Hui404/CoreScribe/CAD/Assemblies/装配.SLDASM

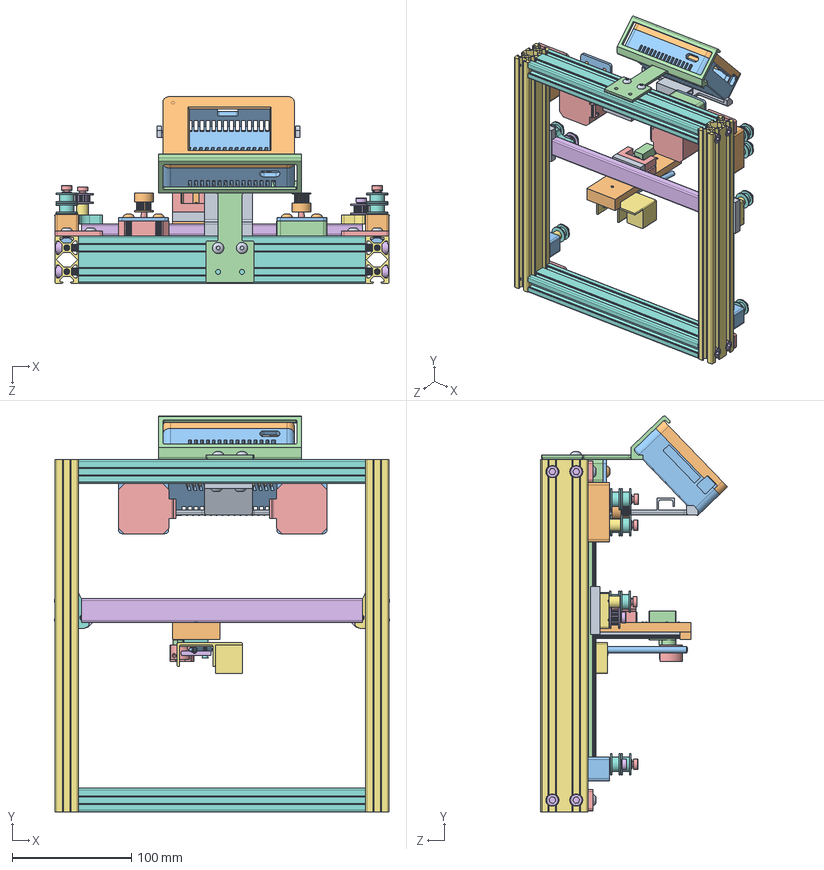
[picture p3: CAD file, 2026-03-18]
CAD/Assemblies/装配.SLDASM
280.8 x 331.6 x 156.7 mm
铝型材2040_X轴_260mm x 2
铝型材2040_Y轴_295mm x 2
内六角平圆头螺钉M6x20 x 8
一字连接片2020型2孔 x 4
线轨180mm x 2
定柱_前 x 2
定柱_后 x 2
MGN9H滑块 x 3
连接件_右
连接件_左
铝型材1020
步进电机 x 2
电机增高柱2
电机安装支架 x 2
同步轮20齿内孔5带宽6 x 2
垫片M5x8x0.5 x 22
惰轮_20齿内孔5带宽6不带齿 x 10
隔离柱 x 4
惰轮_20齿内孔5带宽6带齿 x 2
固定连接
内六角平圆头螺钉M3x8
滑块螺母20型材M5 x 22
内六角平圆头螺钉M5x20 x 4
内六角平圆头螺钉M5x8 x 16
平头内六角螺钉M3x10 x 9
平头内六角螺钉M5x12 x 2
内六角台阶螺钉5xM4x10 x 4
内六角台阶螺钉5xM4x20 x 6
SG90
笔芯
连接件2.1
线轨50mm
MGN9C滑块
连接件2.2
连接件2.3
连接件_棉线
支架1
外壳1
外壳2
支架2
