Hui404/CoreScribe/CAD/3D打印文件/显示器支架1.STL

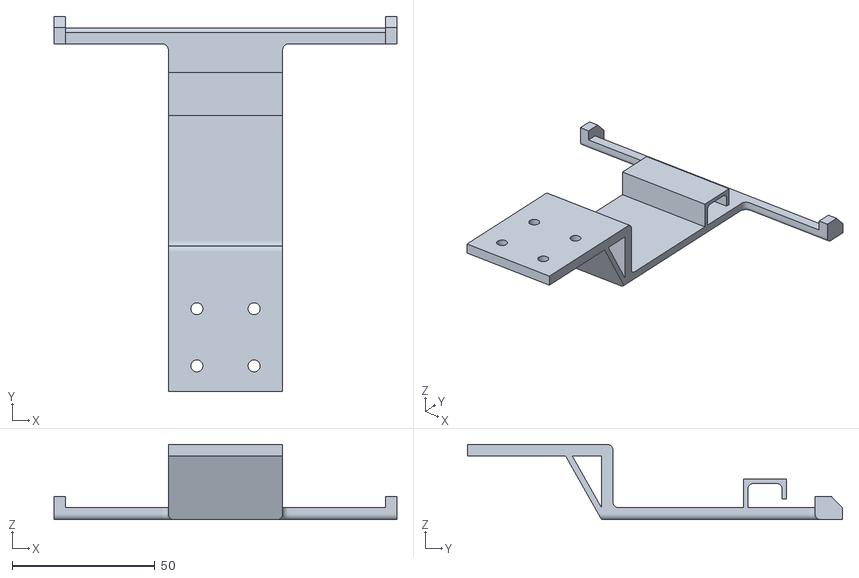
[picture p4: CAD file, 2026-03-18]
CAD/3D打印文件/显示器支架1.STL
120.0 x 131.3 x 26.3
