Hui404/CoreScribe/CAD/parts/内六角台阶螺钉5xM4x20.SLDPRT

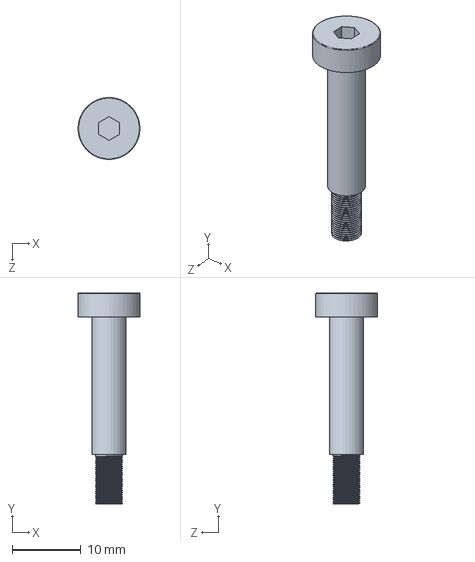
[picture p5: CAD file, 2026-03-18]
CAD/parts/内六角台阶螺钉5xM4x20.SLDPRT
9.00 x 30.7 x 9.00 mm
