Hui404/CoreScribe/CAD/3D打印文件/舵机连接件3.STL

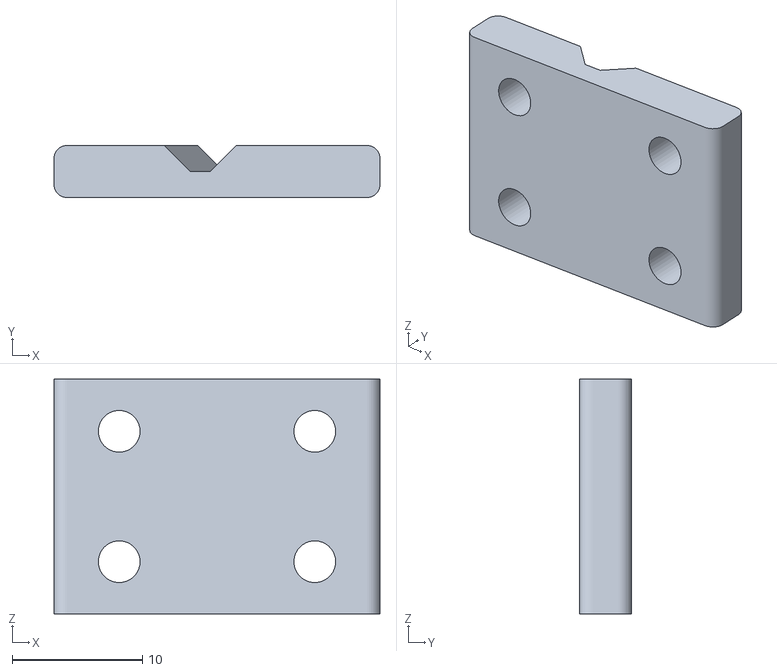
[picture p6: CAD file, 2026-03-18]
CAD/3D打印文件/舵机连接件3.STL
25.0 x 4.00 x 18.0
