Hui404/CoreScribe/CAD/parts/电机增高柱2.SLDPRT

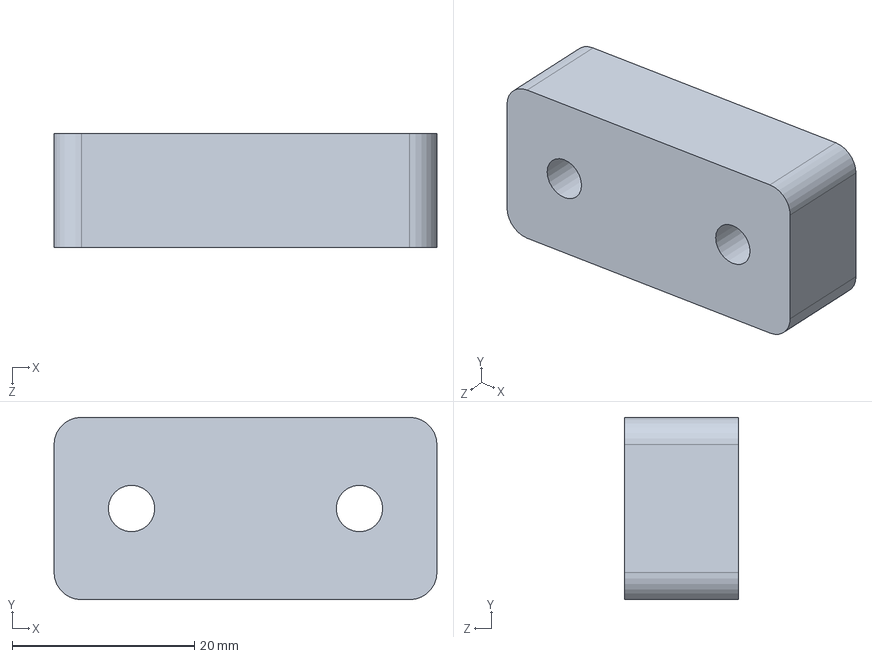
[picture p7: CAD file, 2026-03-18]
CAD/parts/电机增高柱2.SLDPRT
42.0 x 20.0 x 12.5 mm
