Hui404/CoreScribe/CAD/3D打印文件/舵机连接件1.STL

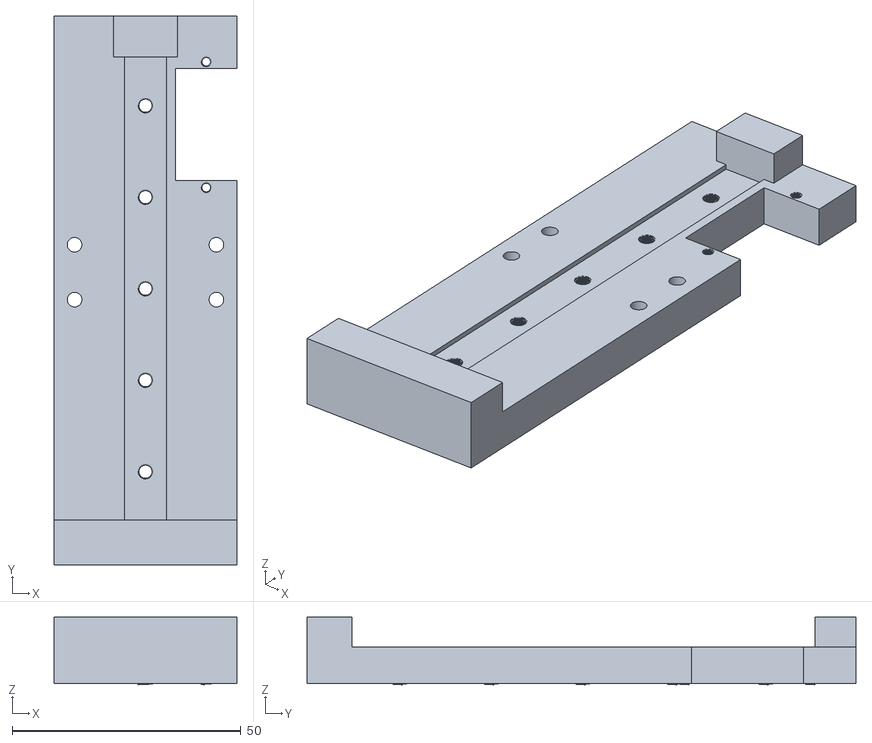
[picture p8: CAD file, 2026-03-18]
CAD/3D打印文件/舵机连接件1.STL
40.0 x 120.0 x 14.8
