Hui404/CoreScribe/CAD/parts/外壳2.SLDPRT

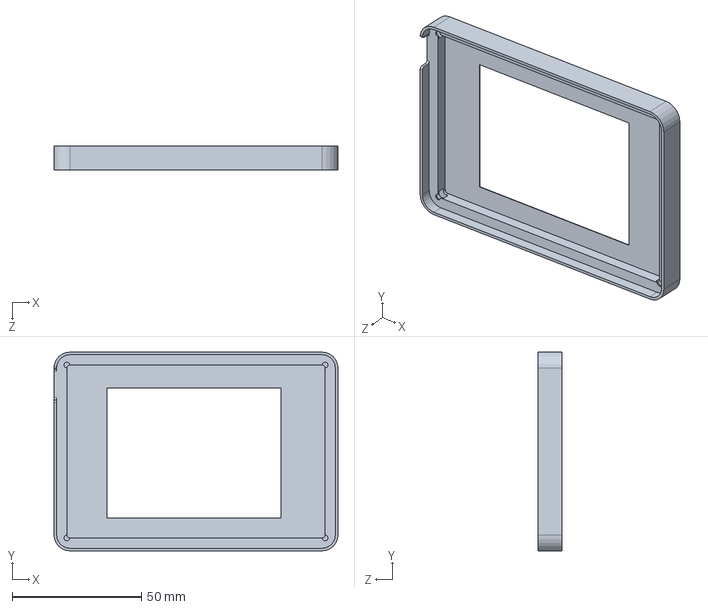
[picture p9: CAD file, 2026-03-18]
CAD/parts/外壳2.SLDPRT
110.0 x 77.0 x 9.30 mm
