Hui404/CoreScribe/CAD/3D打印文件/控制器外壳1.STL

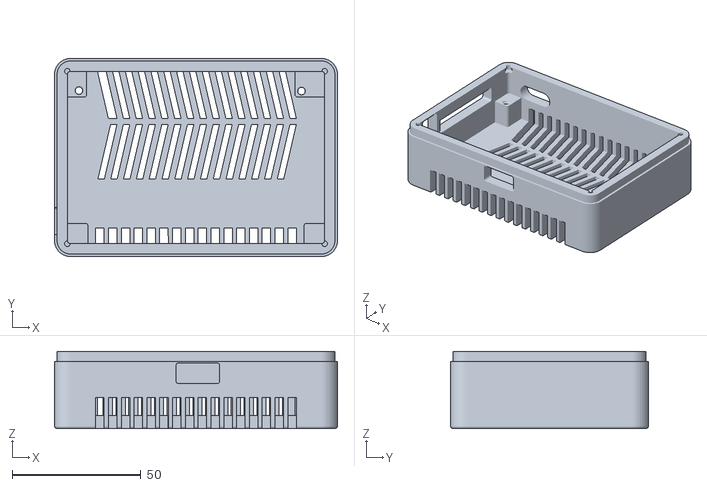
[picture p10: CAD file, 2026-03-18]
CAD/3D打印文件/控制器外壳1.STL
110.0 x 77.0 x 30.0
