Hui404/CoreScribe/CAD/parts/内六角台阶螺钉5xM4x10.SLDPRT

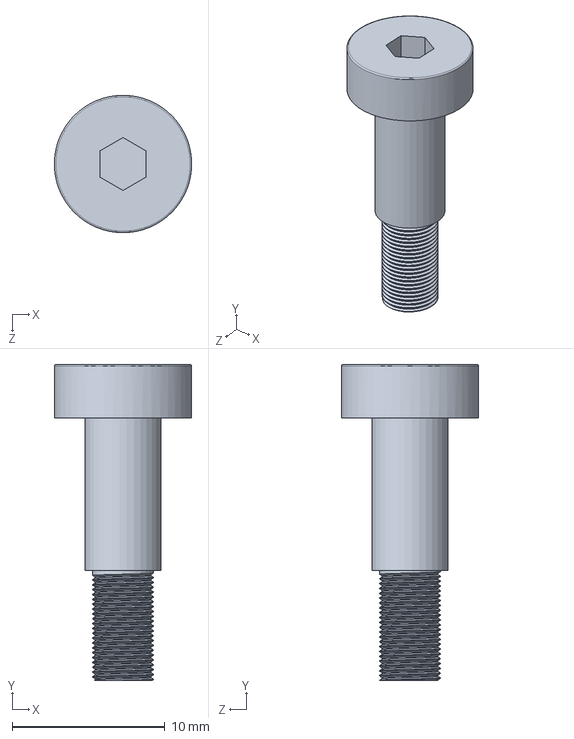
[picture p11: CAD file, 2026-03-18]
CAD/parts/内六角台阶螺钉5xM4x10.SLDPRT
9.00 x 20.7 x 9.00 mm
