Hui404/CoreScribe/CAD/parts/SG90.SLDPRT

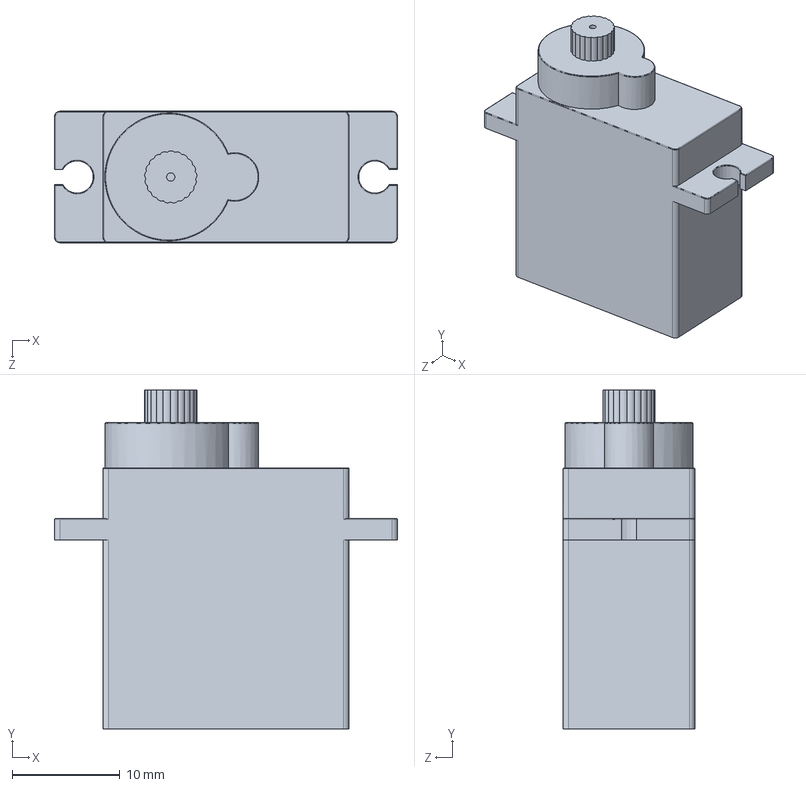
[picture p12: CAD file, 2026-03-18]
CAD/parts/SG90.SLDPRT
31.8 x 31.4 x 12.2 mm
