Hui404/CoreScribe/CAD/3D打印文件/连接件_右.STL

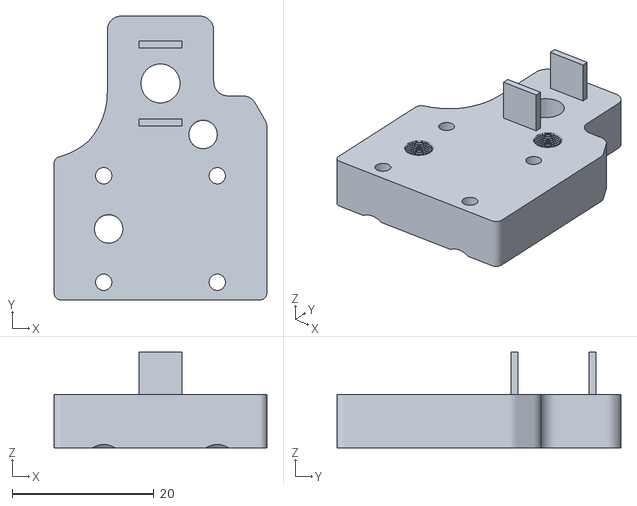
[picture p13: CAD file, 2026-03-18]
CAD/3D打印文件/连接件_右.STL
30.0 x 40.0 x 13.5
