Hui404/CoreScribe/CAD/parts/连接件_棉线.SLDPRT

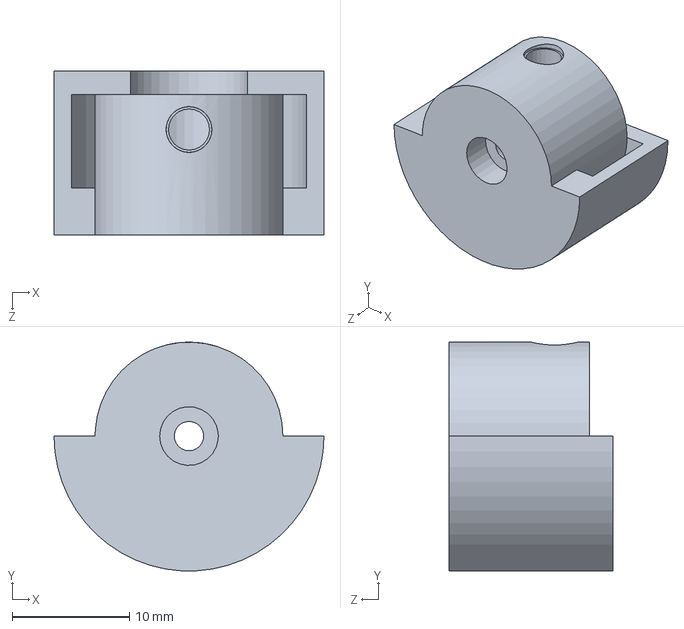
[picture p14: CAD file, 2026-03-18]
CAD/parts/连接件_棉线.SLDPRT
23.0 x 19.5 x 14.0 mm
