Hui404/CoreScribe/CAD/3D打印文件/舵机连接件.STL

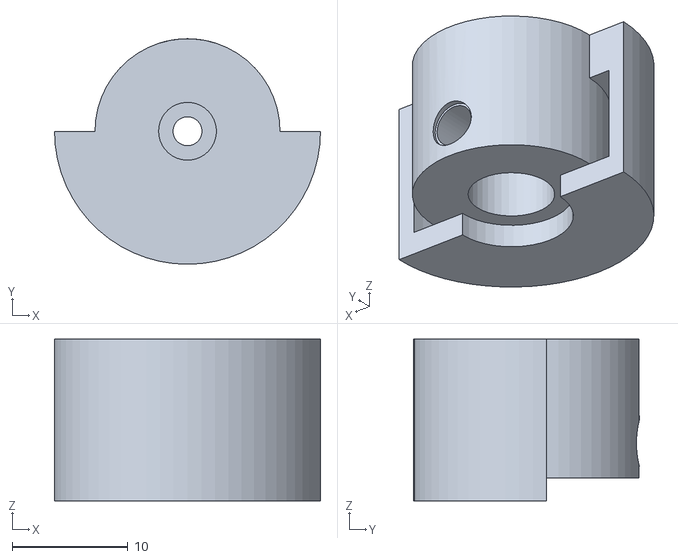
[picture p15: CAD file, 2026-03-18]
CAD/3D打印文件/舵机连接件.STL
23.0 x 19.5 x 14.0
