Hui404/CoreScribe/CAD/parts/惰轮_20齿内孔5带宽6不带齿.SLDPRT

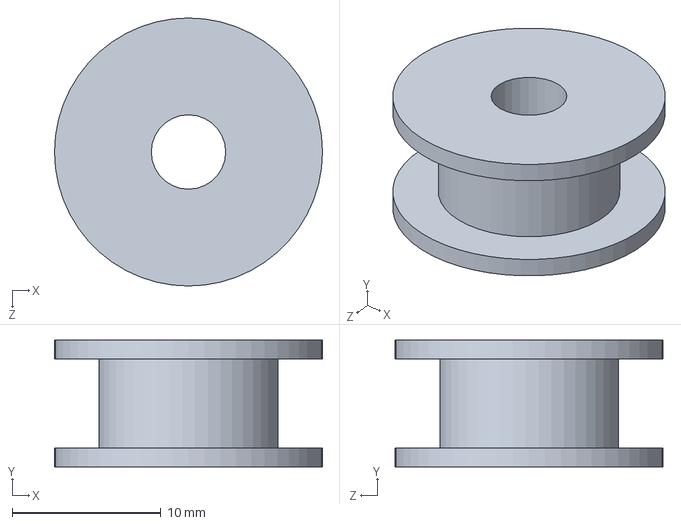
[picture p16: CAD file, 2026-03-18]
CAD/parts/惰轮_20齿内孔5带宽6不带齿.SLDPRT
18.0 x 8.50 x 18.0 mm
