Hui404/CoreScribe/CAD/parts/内六角平圆头螺钉M3x8.SLDPRT

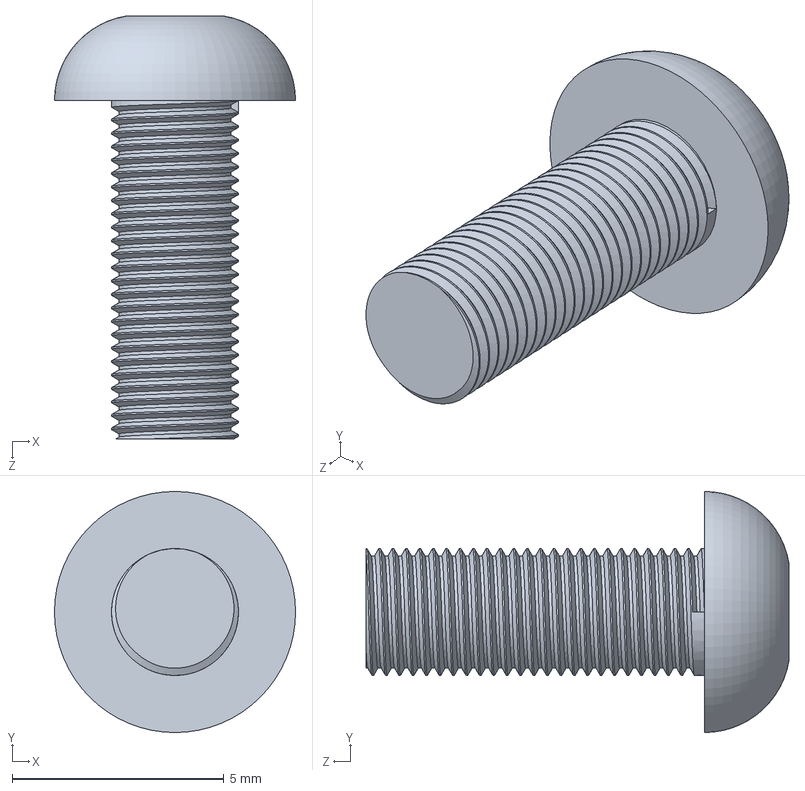
[picture p17: CAD file, 2026-03-18]
CAD/parts/内六角平圆头螺钉M3x8.SLDPRT
5.70 x 5.70 x 10.0 mm
