Hui404/CoreScribe/CAD/parts/平头内六角螺钉M5x12.SLDPRT

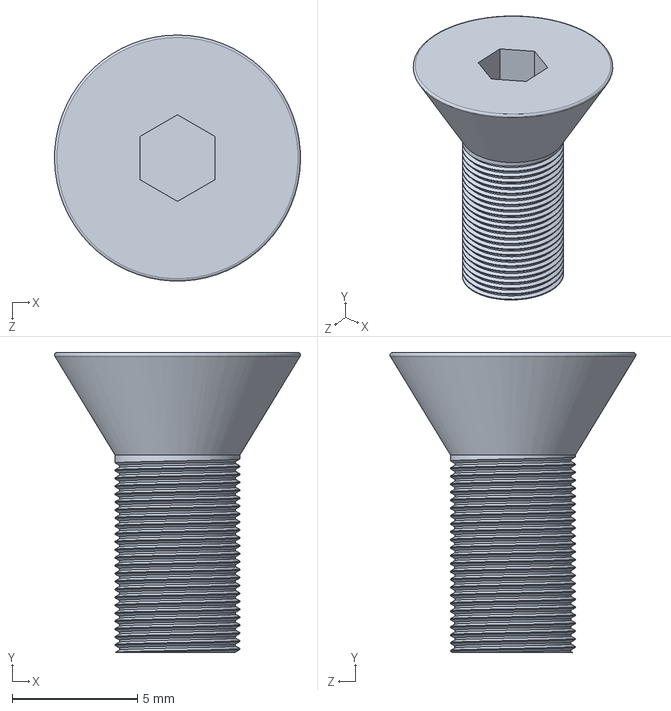
[picture p19: CAD file, 2026-03-18]
CAD/parts/平头内六角螺钉M5x12.SLDPRT
9.84 x 12.0 x 9.84 mm
