Hui404/CoreScribe/CAD/3D打印文件/定柱_后.STL

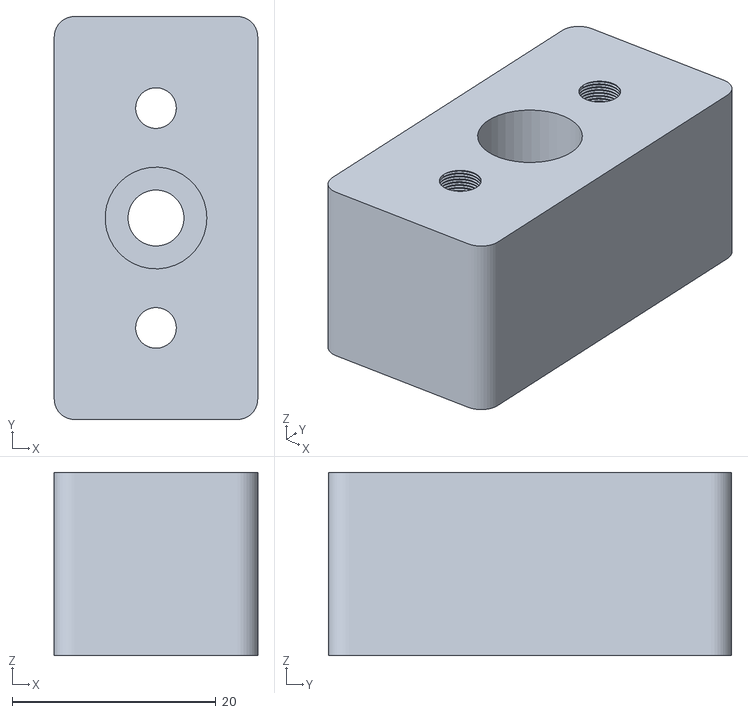
[picture p20: CAD file, 2026-03-18]
CAD/3D打印文件/定柱_后.STL
20.0 x 39.6 x 18.0
