Hui404/CoreScribe/CAD/parts/定柱_前.SLDPRT

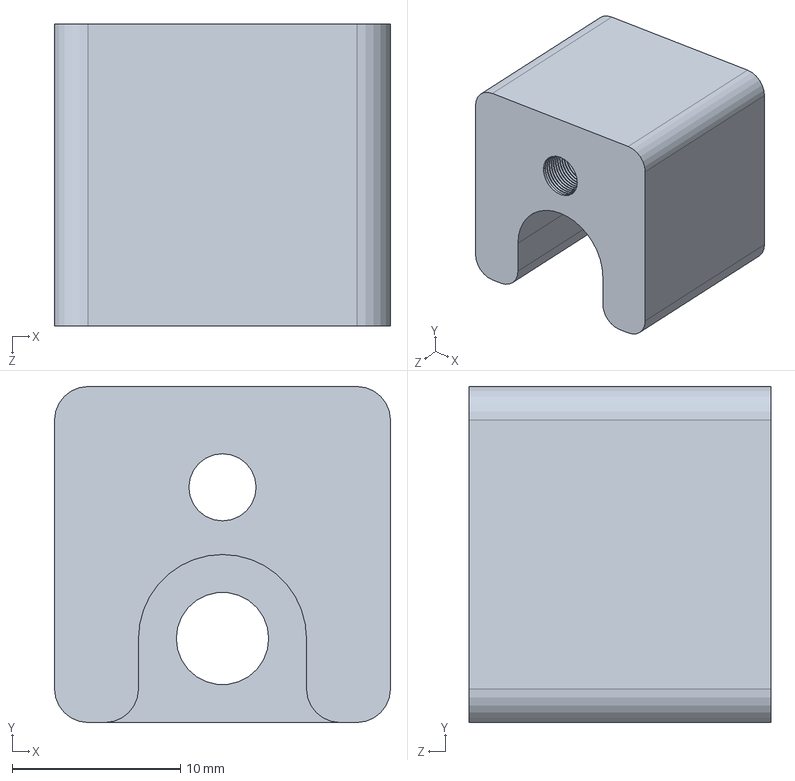
[picture p21: CAD file, 2026-03-18]
CAD/parts/定柱_前.SLDPRT
20.0 x 20.0 x 18.0 mm
