Hui404/CoreScribe/CAD/3D打印文件/舵机连接件2.STL

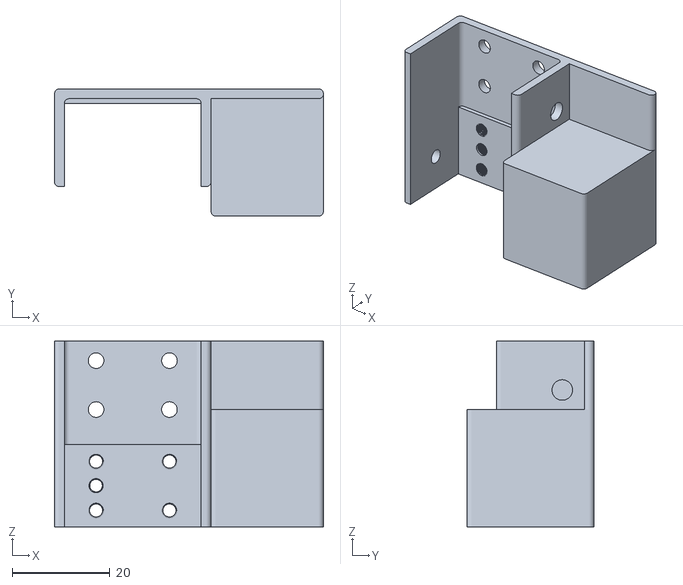
[picture p22: CAD file, 2026-03-18]
CAD/3D打印文件/舵机连接件2.STL
55.0 x 26.0 x 38.0
