Hui404/CoreScribe/CAD/parts/线轨50mm.SLDPRT

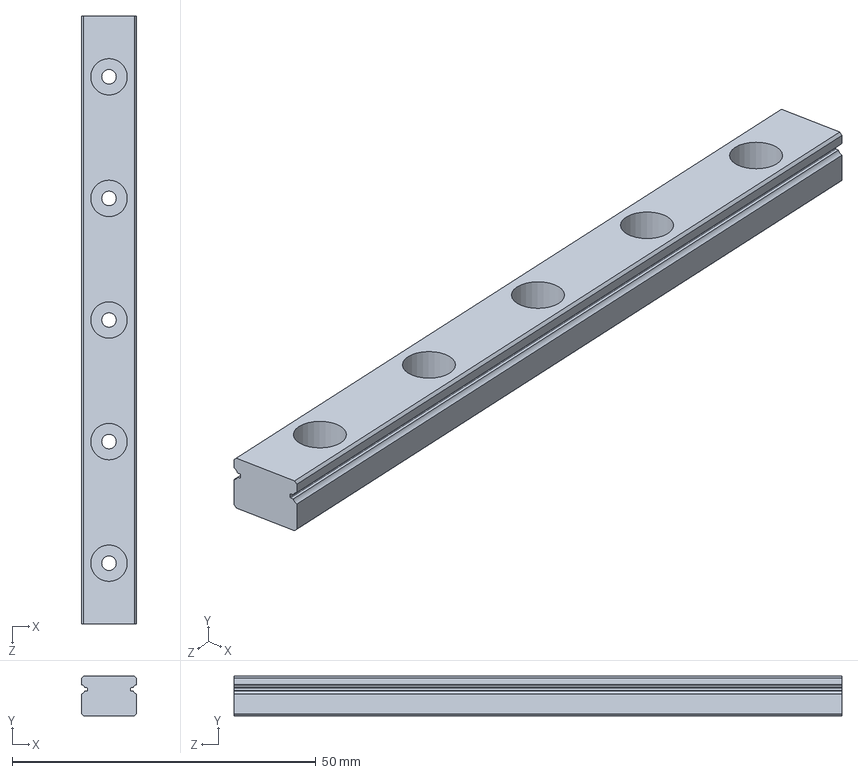
[picture p23: CAD file, 2026-03-18]
CAD/parts/线轨50mm.SLDPRT
9.00 x 6.50 x 100.0 mm
