Hui404/CoreScribe/CAD/3D打印文件/电机安装支架.STL

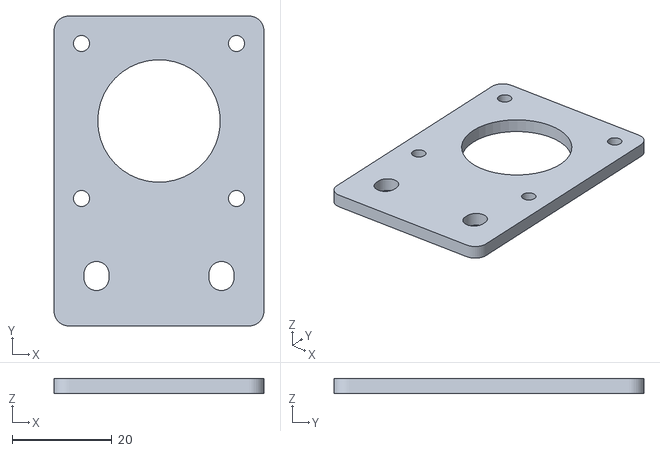
[picture p24: CAD file, 2026-03-18]
CAD/3D打印文件/电机安装支架.STL
42.0 x 62.0 x 3.00
