Hui404/CoreScribe/CAD/3D打印文件/固定连接.STL

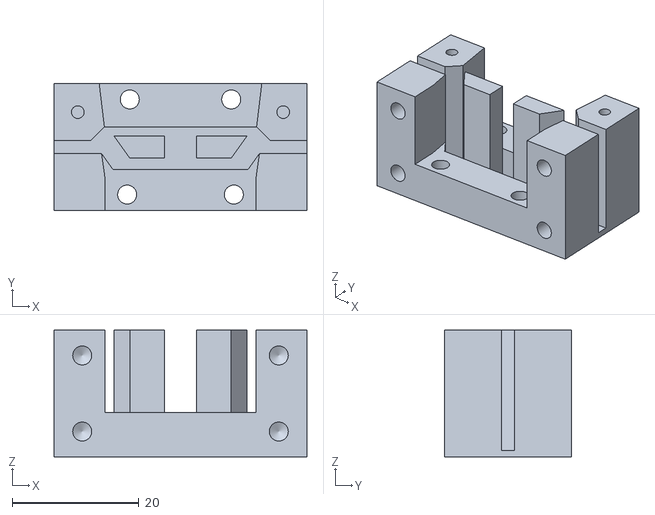
[picture p25: CAD file, 2026-03-18]
CAD/3D打印文件/固定连接.STL
39.9 x 20.0 x 20.0
