Hui404/CoreScribe/CAD/3D打印文件/隔离柱2.STL

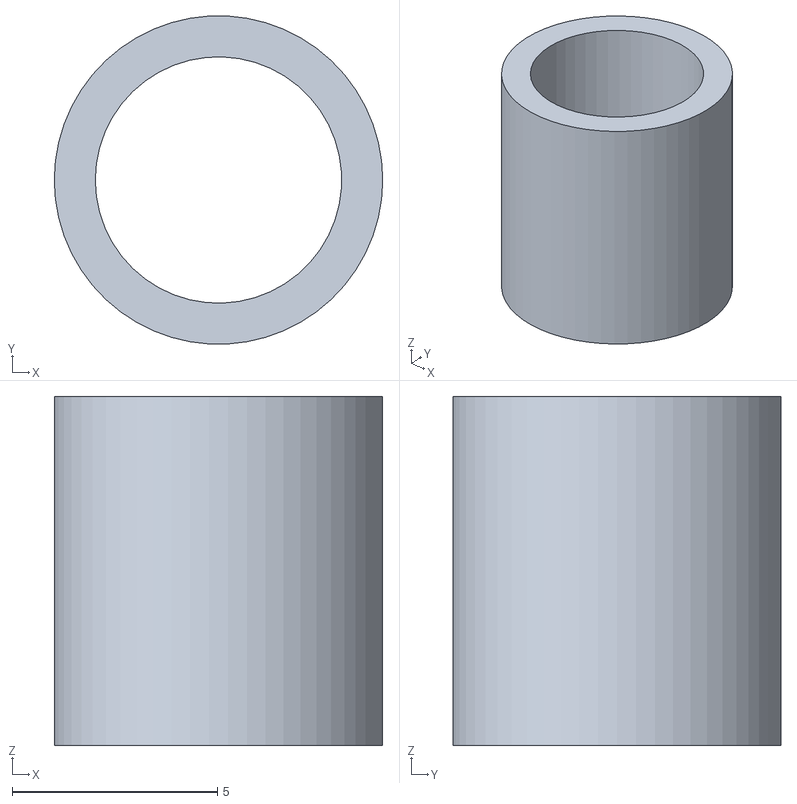
[picture p26: CAD file, 2026-03-18]
CAD/3D打印文件/隔离柱2.STL
8.00 x 7.99 x 8.50
