Hui404/CoreScribe/CAD/parts/铝型材1020.SLDPRT

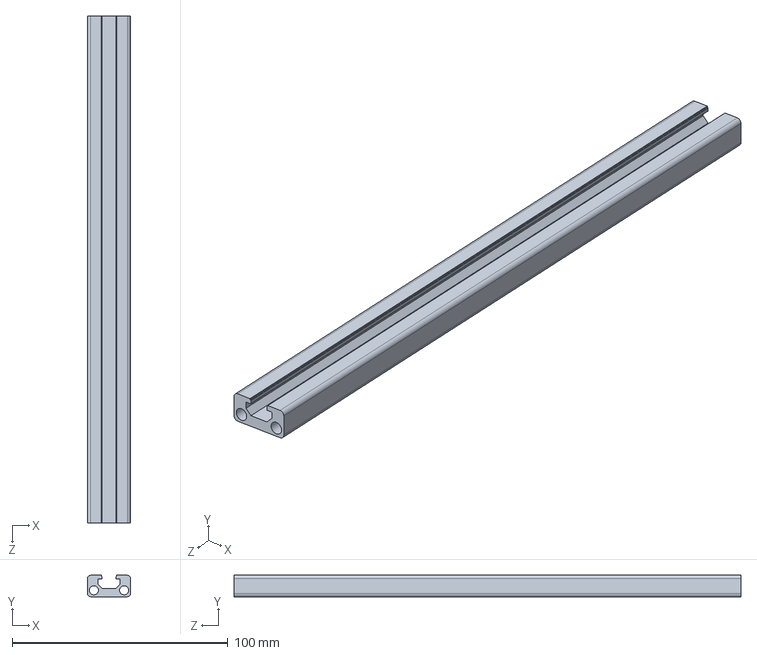
[picture p27: CAD file, 2026-03-18]
CAD/parts/铝型材1020.SLDPRT
20.0 x 10.0 x 235.0 mm
