Hui404/CoreScribe/CAD/parts/连接件_右.SLDPRT

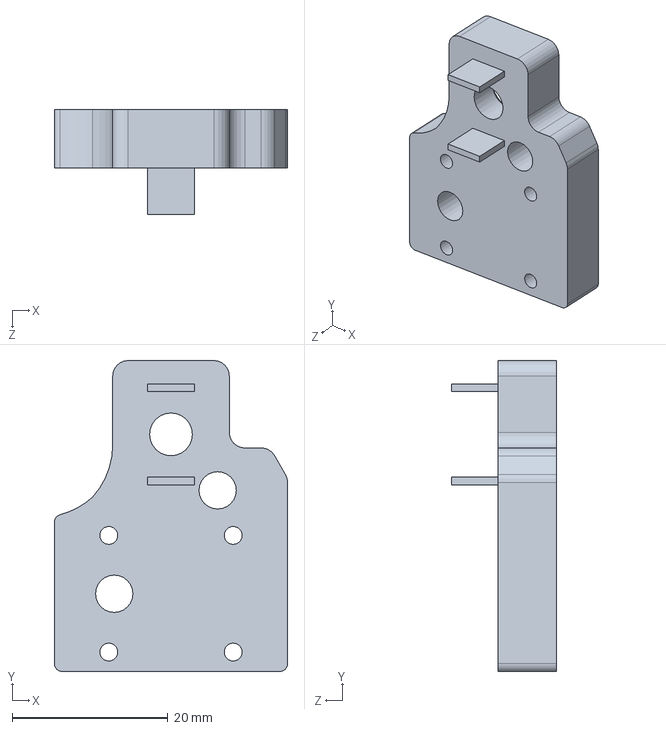
[picture p28: CAD file, 2026-03-18]
CAD/parts/连接件_右.SLDPRT
30.0 x 40.0 x 13.5 mm
