Hui404/CoreScribe/CAD/parts/线轨180mm.SLDPRT

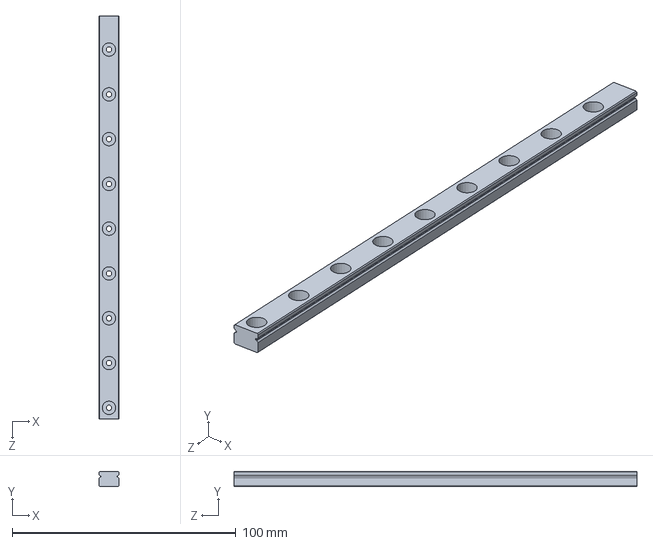
[picture p29: CAD file, 2026-03-18]
CAD/parts/线轨180mm.SLDPRT
9.00 x 6.50 x 180.0 mm
