Hui404/CoreScribe/CAD/parts/铝型材2040_X轴_260mm.SLDPRT

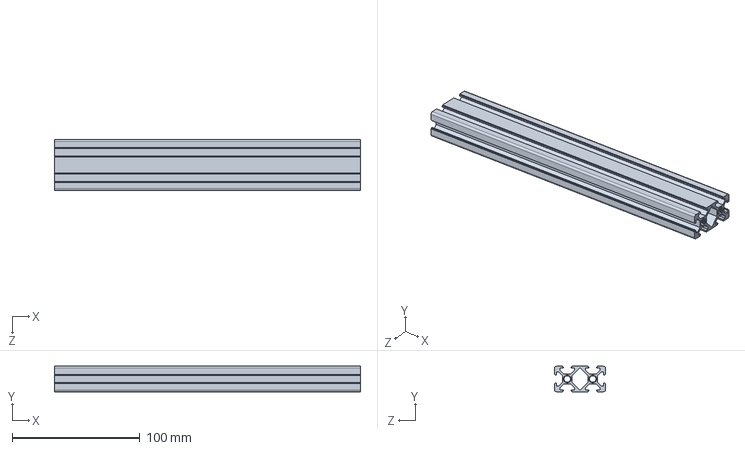
[picture p30: CAD file, 2026-03-18]
CAD/parts/铝型材2040_X轴_260mm.SLDPRT
240.0 x 20.0 x 40.0 mm
