Hui404/CoreScribe/CAD/parts/内六角平圆头螺钉M5x20.SLDPRT

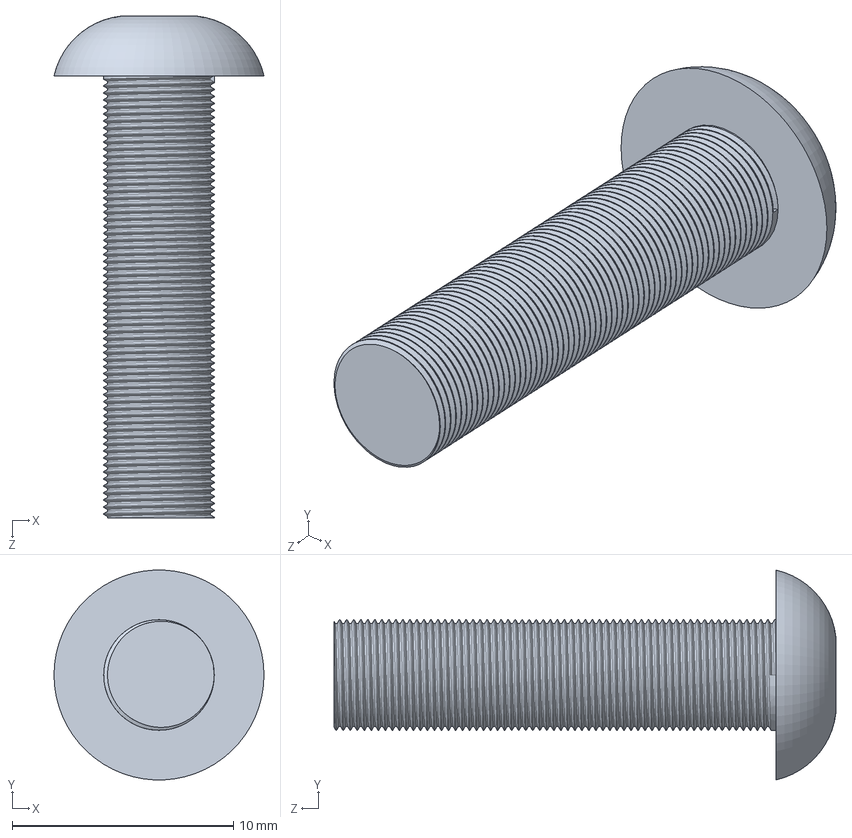
[picture p31: CAD file, 2026-03-18]
CAD/parts/内六角平圆头螺钉M5x20.SLDPRT
9.50 x 9.49 x 22.7 mm
