Hui404/CoreScribe/CAD/parts/内六角平圆头螺钉M5x8.SLDPRT

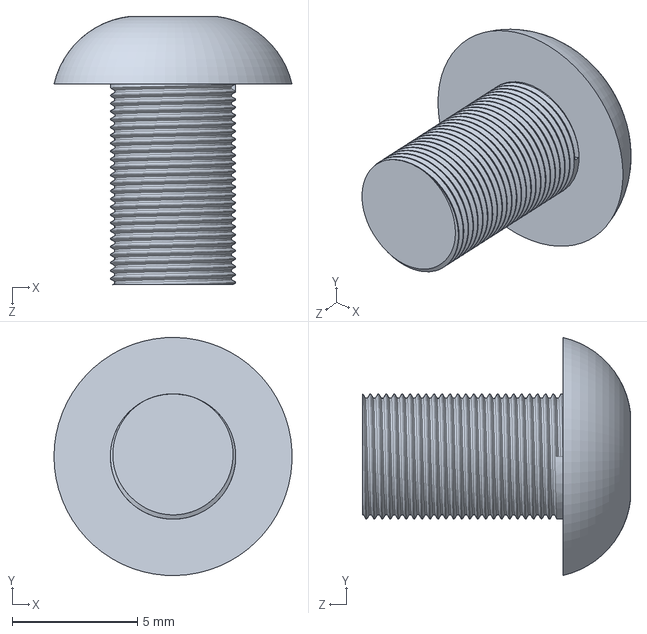
[picture p32: CAD file, 2026-03-18]
CAD/parts/内六角平圆头螺钉M5x8.SLDPRT
9.49 x 9.50 x 10.7 mm
