Hui404/CoreScribe/CAD/parts/平头内六角螺钉M3x10.SLDPRT

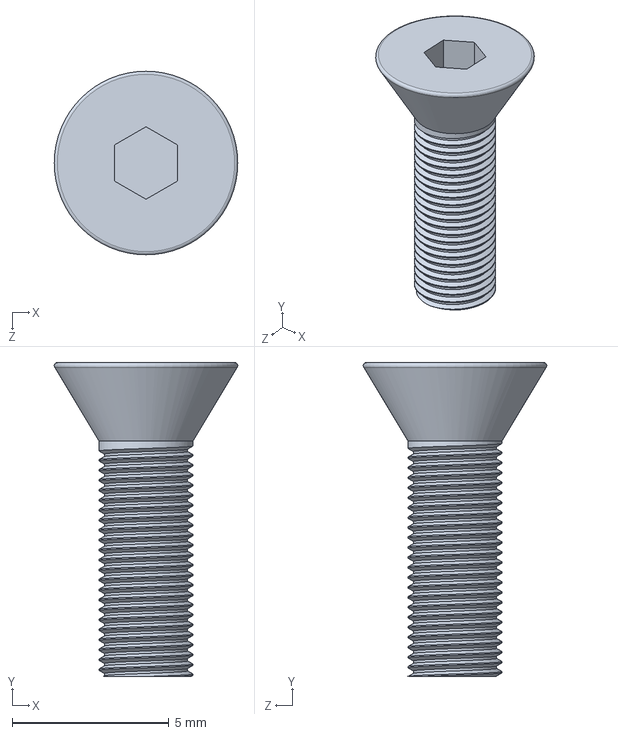
[picture p33: CAD file, 2026-03-18]
CAD/parts/平头内六角螺钉M3x10.SLDPRT
5.85 x 10.0 x 5.85 mm
