Hui404/CoreScribe/CAD/parts/步进电机.SLDPRT

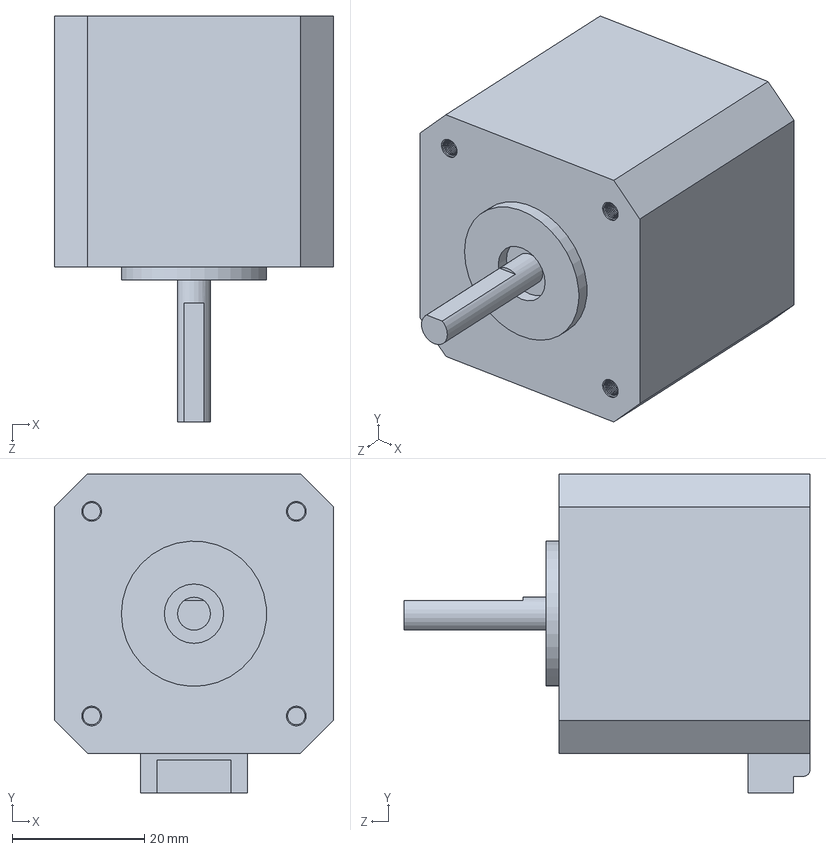
[picture p34: CAD file, 2026-03-18]
CAD/parts/步进电机.SLDPRT
42.3 x 48.3 x 61.5 mm
