Hui404/CoreScribe/CAD/parts/MGN9C滑块.SLDPRT

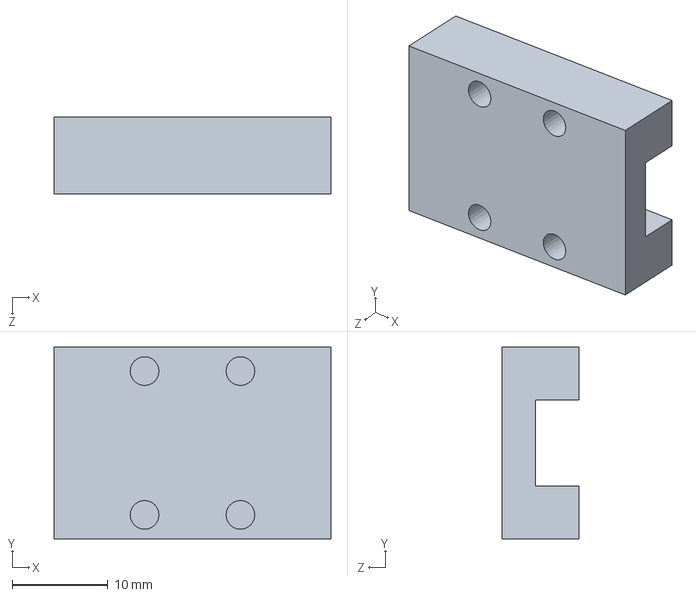
[picture p35: CAD file, 2026-03-18]
CAD/parts/MGN9C滑块.SLDPRT
28.9 x 20.0 x 8.00 mm
