Hui404/CoreScribe/CAD/parts/隔离柱.SLDPRT

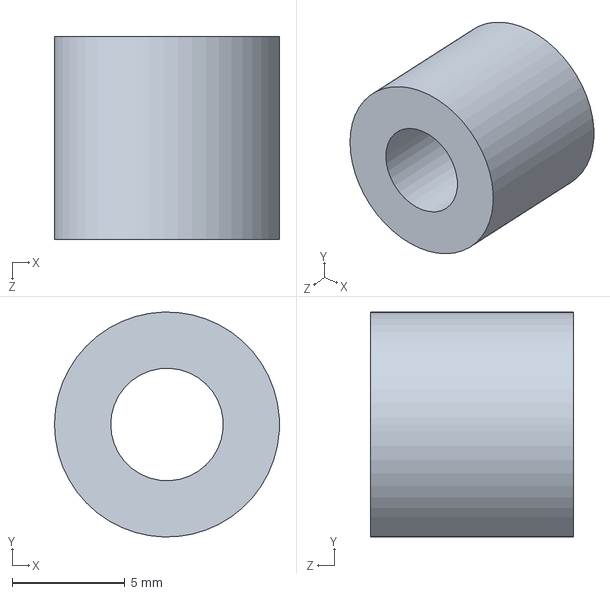
[picture p36: CAD file, 2026-03-18]
CAD/parts/隔离柱.SLDPRT
10.0 x 9.99 x 9.00 mm
