Hui404/CoreScribe/CAD/parts/定柱_后.SLDPRT

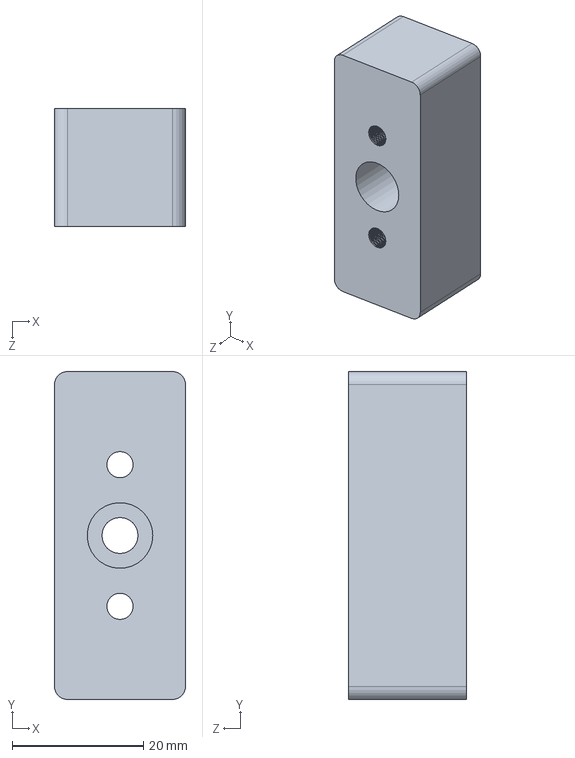
[picture p37: CAD file, 2026-03-18]
CAD/parts/定柱_后.SLDPRT
20.0 x 50.0 x 18.0 mm
