Hui404/CoreScribe/CAD/parts/MGN9H滑块.SLDPRT

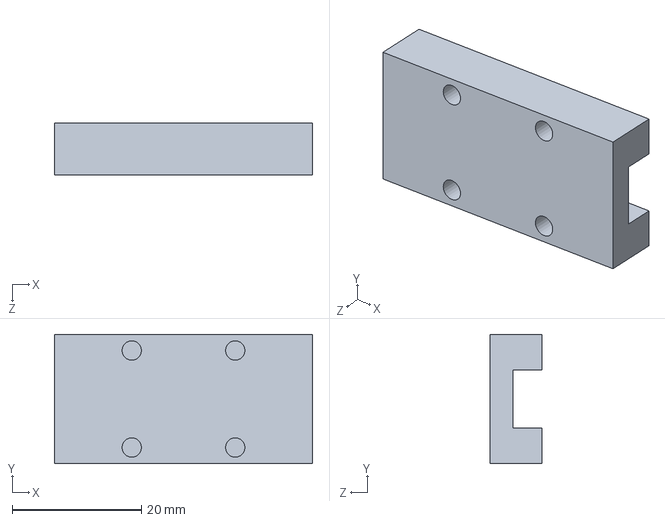
[picture p38: CAD file, 2026-03-18]
CAD/parts/MGN9H滑块.SLDPRT
39.9 x 20.0 x 8.00 mm
