Hui404/CoreScribe/CAD/parts/同步轮20齿内孔5带宽6.SLDPRT

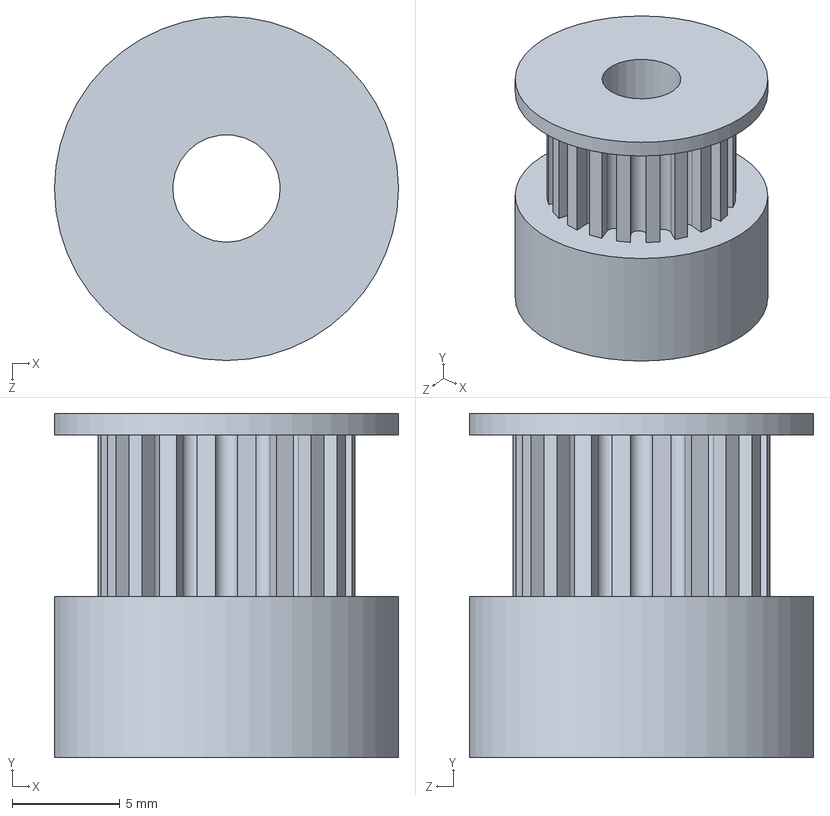
[picture p39: CAD file, 2026-03-18]
CAD/parts/同步轮20齿内孔5带宽6.SLDPRT
16.0 x 16.0 x 16.0 mm
