Hui404/CoreScribe/CAD/parts/垫片M5x8x0.5.SLDPRT

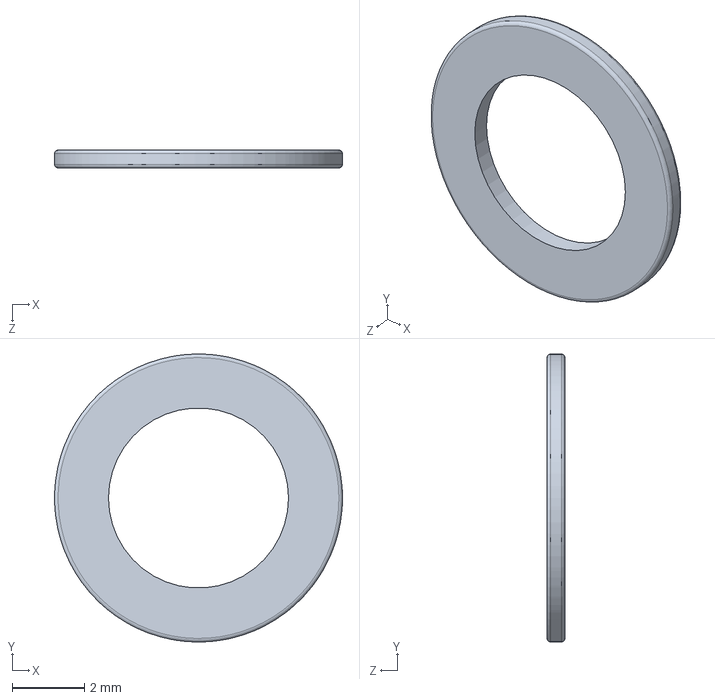
[picture p40: CAD file, 2026-03-18]
CAD/parts/垫片M5x8x0.5.SLDPRT
8.00 x 8.00 x 0.5 mm
