Hui404/CoreScribe/CAD/parts/一字连接片2020型2孔.SLDPRT

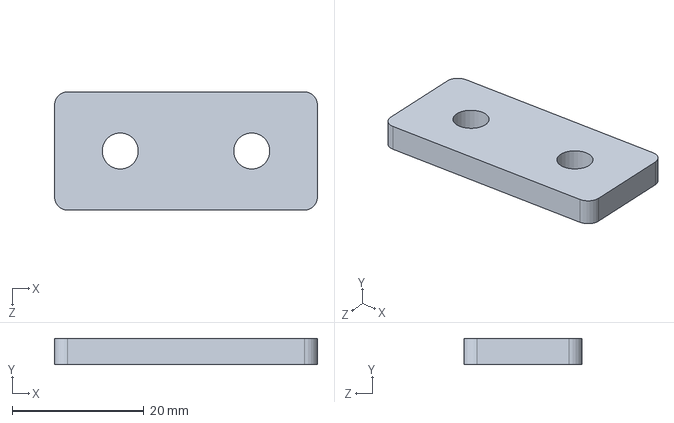
[picture p41: CAD file, 2026-03-18]
CAD/parts/一字连接片2020型2孔.SLDPRT
40.0 x 4.00 x 18.0 mm
