Hui404/CoreScribe/CAD/parts/支架1.SLDPRT

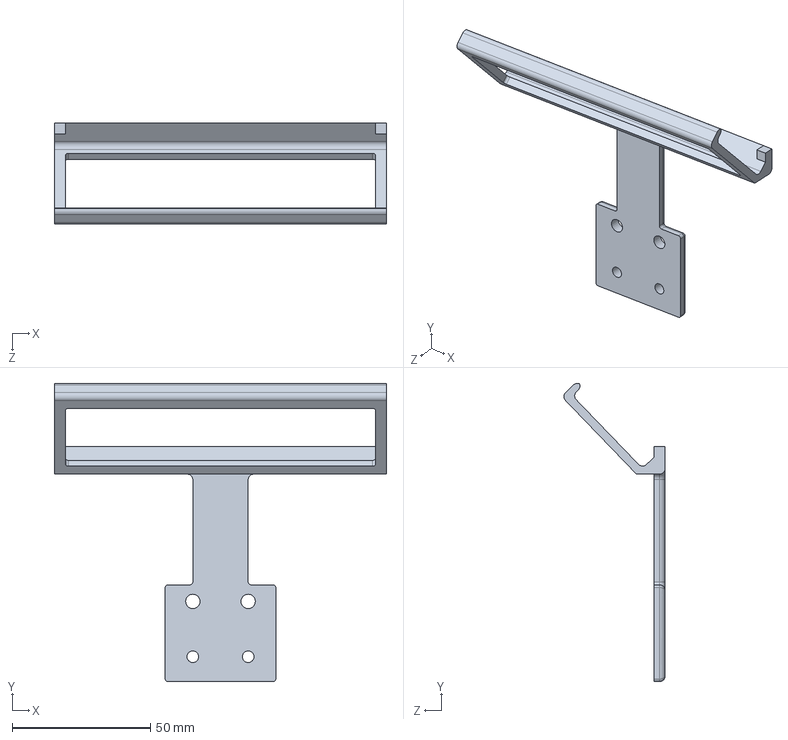
[picture p42: CAD file, 2026-03-18]
CAD/parts/支架1.SLDPRT
120.0 x 107.8 x 36.6 mm
