Hui404/CoreScribe/CAD/parts/内六角平圆头螺钉M6x20.SLDPRT

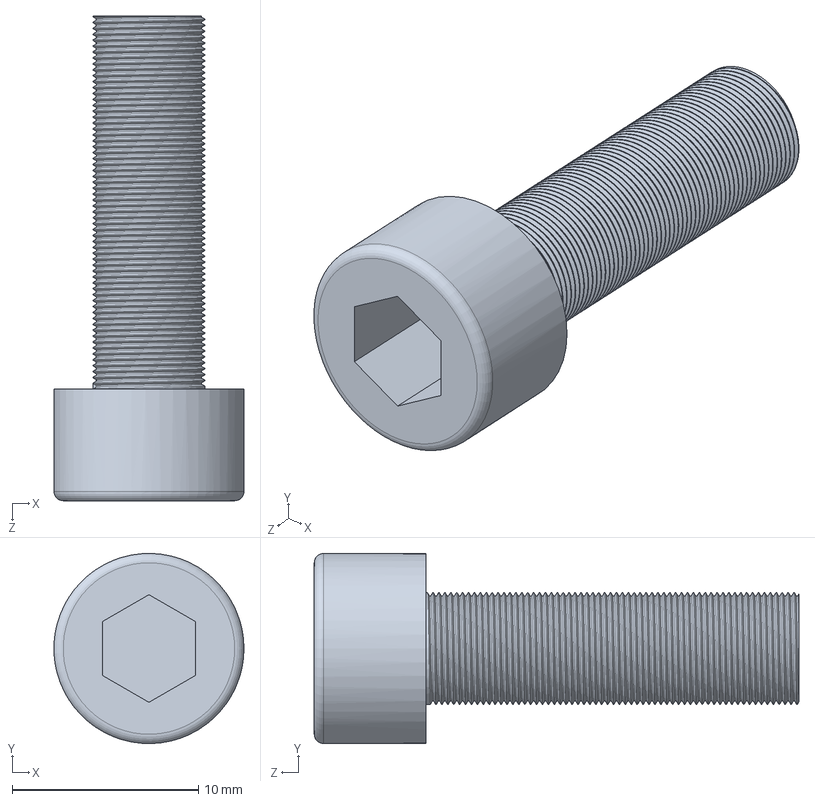
[picture p43: CAD file, 2026-03-18]
CAD/parts/内六角平圆头螺钉M6x20.SLDPRT
10.2 x 10.2 x 26.0 mm
