Hui404/CoreScribe/CAD/parts/笔芯.SLDPRT

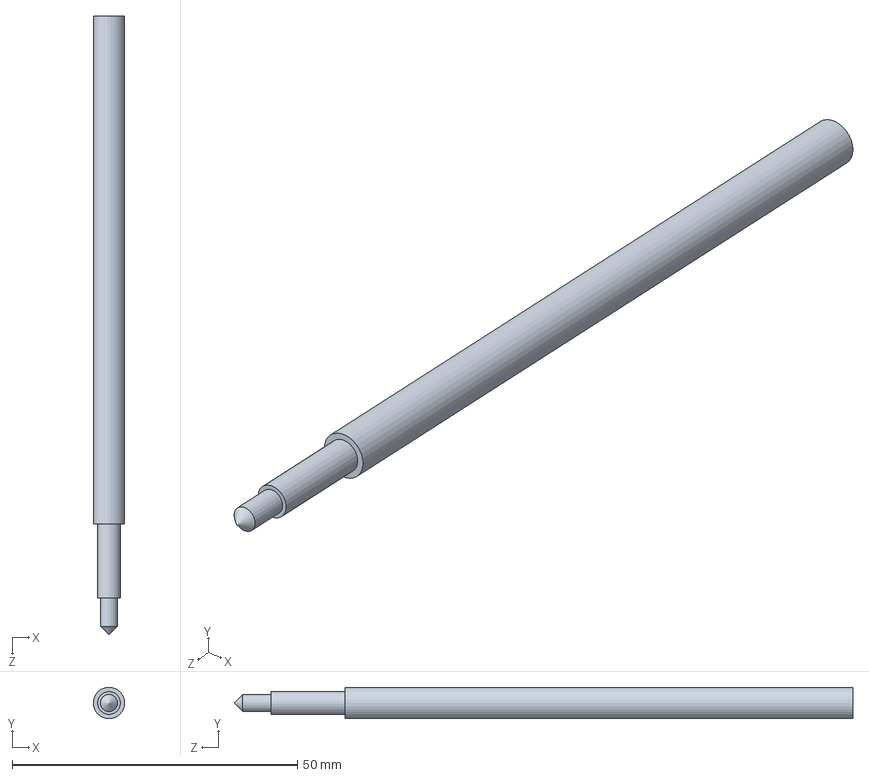
[picture p44: CAD file, 2026-03-18]
CAD/parts/笔芯.SLDPRT
5.50 x 5.47 x 108.5 mm
