Hui404/CoreScribe/CAD/parts/滑块螺母20型材M5.SLDPRT

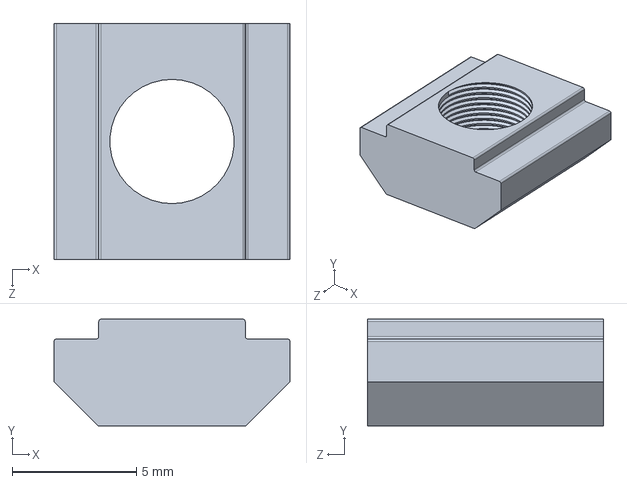
[picture p45: CAD file, 2026-03-18]
CAD/parts/滑块螺母20型材M5.SLDPRT
9.50 x 4.30 x 9.50 mm
