Hui404/CoreScribe/CAD/parts/铝型材2040_Y轴_295mm.SLDPRT

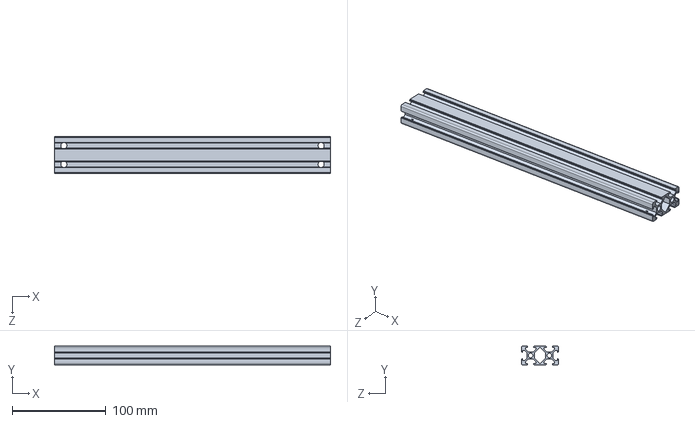
[picture p46: CAD file, 2026-03-18]
CAD/parts/铝型材2040_Y轴_295mm.SLDPRT
295.0 x 20.0 x 40.0 mm
