Hui404/CoreScribe/CAD/parts/线轨200mm.SLDPRT

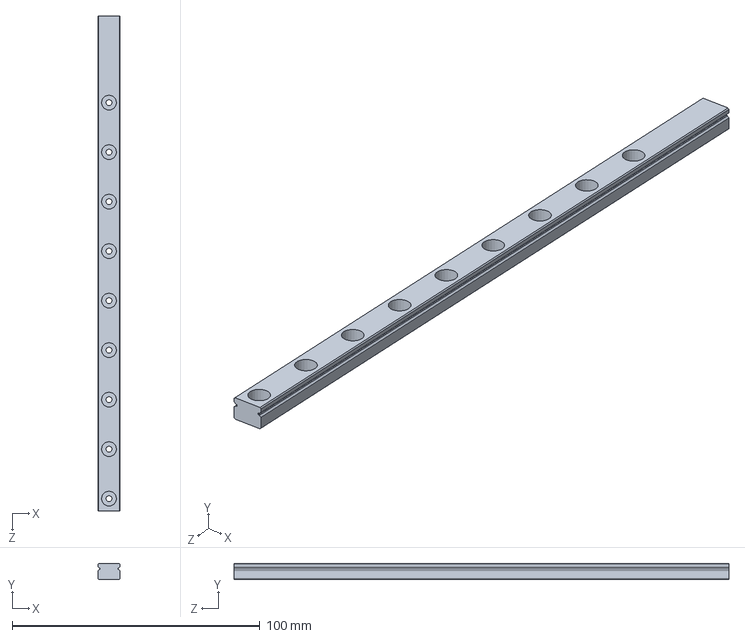
[picture p47: CAD file, 2026-03-18]
CAD/parts/线轨200mm.SLDPRT
9.00 x 6.50 x 200.0 mm
