Hui404/CoreScribe/(list of files, cad)

Other CAD files:
CAD/3D打印文件/控制器外壳2.STL
CAD/3D打印文件/显示器支架2.STL
CAD/parts/电机安装支架.SLDPRT
CAD/parts/连接件2.3.SLDPRT
CAD/3D打印文件/电机增高柱.STL
CAD/parts/外壳1.SLDPRT
CAD/3D打印文件/定柱_前.STL
CAD/parts/支架2.SLDPRT
CAD/parts/固定连接.SLDPRT
CAD/parts/惰轮_20齿内孔5带宽6带齿.SLDPRT
CAD/parts/连接件2.2.SLDPRT
CAD/parts/连接件_左.SLDPRT
CAD/parts/连接件2.1.SLDPRT
CAD/parts/电机增高柱.SLDPRT
CAD/parts/铝型材加工图.SLDDRW
