Hui404/CoreScribe/Core/Src/main.c

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
// Includes ------------------------------------------------------------------
#include "main.h"
#include "cmsis_os.h"
#include "tim.h"
#include "usart.h"
#include "gpio.h"
#include "fsmc.h"

// Private includes ----------------------------------------------------------
/* USER CODE BEGIN Includes */
#include "grbl.h"

#include "MyDelay.h"
#include "ILI9341_LCD.h"
#include "XPT2046_touch.h"
#include "lvgl.h"
#include "lv_port_disp_template.h"
#include "lv_port_indev_template.h"
//#include "lv_demo_stress.h"
//#include "malloc.h"
#include "servo.h"
#include "touch_calibration.h"
// demo
//#include "lv_demo_music.h"


#include <string.h>

/* USER CODE END Includes */

// Private typedef -----------------------------------------------------------
// Private define ------------------------------------------------------------
// Private macro -------------------------------------------------------------
// Private variables ---------------------------------------------------------

// Private function prototypes -----------------------------------------------
void SystemClock_Config(void);
void MX_FREERTOS_Init(void);
// Private user code ---------------------------------------------------------
/**
  * @brief  The application entry point.
  * @retval int
  */
int main(void)
{

  // MCU Configuration--------------------------------------------------------

  // Reset of all peripherals, Initializes the Flash interface and the Systick.
  HAL_Init();

  // Configure the system clock
  SystemClock_Config();

  // Initialize all configured peripherals
  MX_GPIO_Init();
  MX_USART1_UART_Init();
  MX_FSMC_Init();
  MX_TIM5_Init();
  MX_TIM2_Init();
  MX_TIM3_Init();
  MX_TIM4_Init();
  /* USER CODE BEGIN 2 */
  MyDelay_Init();
  Servo_Init();
  //HAL_TIM_Base_Start_IT(&htim5);
  SCB->CPACR |= ((3UL << 10*2)|(3UL << 11*2));

  //my_mem_init(SRAMIN);
  ILI9341_LCD_Init();
  XPT2046_Init();
  ILI9341_Clear();


  lv_init();
  // 这里只初始化LVGL内核；显示和触摸驱动在defaultTask里再初始化。


//  lv_port_disp_init();
//  lv_port_indev_init();
  //lv_demo_stress();

  Servo_SetPulseUs(PEN_UP_POSITION);




  	  //  lv_port_disp_init();
  	  //  lv_port_indev_init();
//
//      lv_obj_t* switch_obj = lv_switch_create(lv_scr_act());
//      lv_obj_set_size(switch_obj, 120, 60);
//      lv_obj_align(switch_obj, LV_ALIGN_CENTER, 0, 0);

  //grbl_Start();

  //ILI9341_Draw_Rec(10, 10, 200, 150, 0xf12547);

  touch_calibration_init();
  // 先把校准模块准备好，后面由LVGL任务定期调用touch_calibration_process。

  /* USER CODE END 2 */

  // Init scheduler
  // 这里会创建FreeRTOS任务对象（包含LVGL任务和Grbl任务）。
  osKernelInitialize();  // Call init function for freertos objects (in cmsis_os2.c)
  MX_FREERTOS_Init();

  // Start scheduler

  // 启动后控制权交给调度器，正常情况下不会返回到这里。
  osKernelStart();

  // We should never get here as control is now taken by the scheduler

  // Infinite loop
  /* USER CODE BEGIN WHILE */



  while (1)
  {

	  		MyDelay_ms(5);
	  		lv_timer_handler();


    /* USER CODE END WHILE */

    /* USER CODE BEGIN 3 */

  }
  /* USER CODE END 3 */
}

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
