Hui404/CoreScribe/grbl/defaults.h

  #define DEFAULT_X_STEPS_PER_MM 80.0	//步进电机每毫米步数
  #define DEFAULT_Y_STEPS_PER_MM 80.0
  #define DEFAULT_Z_STEPS_PER_MM 80.0
  #define DEFAULT_X_MAX_RATE 3000.0 // mm/min	//最大移动速度
  #define DEFAULT_Y_MAX_RATE 3000.0 // mm/min
  #define DEFAULT_Z_MAX_RATE 1000.0 // mm/min
  #define DEFAULT_X_ACCELERATION (300.0*60*60) // 10*60*60 mm/min^2 = 10 mm/sec^2	//加速度
  #define DEFAULT_Y_ACCELERATION (300.0*60*60) // 10*60*60 mm/min^2 = 10 mm/sec^2
  #define DEFAULT_Z_ACCELERATION (100.0*60*60) // 10*60*60 mm/min^2 = 10 mm/sec^2
  #define DEFAULT_X_MAX_TRAVEL 200.0 // mm NOTE: Must be a positive value.	//最大行程
  #define DEFAULT_Y_MAX_TRAVEL 180.0 // mm NOTE: Must be a positive value.
  #define DEFAULT_Z_MAX_TRAVEL 200.0 // mm NOTE: Must be a positive value.
  #define DEFAULT_SPINDLE_RPM_MAX 1000.0 // rpm
  #define DEFAULT_SPINDLE_RPM_MIN 0.0 // rpm
  #define DEFAULT_STEP_PULSE_MICROSECONDS 10	//步进脉冲设置
  #define DEFAULT_STEPPING_INVERT_MASK 0
  #define DEFAULT_DIRECTION_INVERT_MASK 0
  #define DEFAULT_STEPPER_IDLE_LOCK_TIME 250 // msec (0-254, 255 keeps steppers enabled) 步进电机空闲锁定时间
  #define DEFAULT_STATUS_REPORT_MASK 1 // MPos enabled
  #define DEFAULT_JUNCTION_DEVIATION 0.01 // mm
  #define DEFAULT_ARC_TOLERANCE 0.001 // mm
  #define DEFAULT_REPORT_INCHES 0 // false
  #define DEFAULT_INVERT_ST_ENABLE 1 // false
  #define DEFAULT_INVERT_LIMIT_PINS 1 // false // 启用软限位保护
  #define DEFAULT_SOFT_LIMIT_ENABLE 0 // false // 禁用硬限位
  #define DEFAULT_HARD_LIMIT_ENABLE 0  // false
  #define DEFAULT_INVERT_PROBE_PIN 0 // false
  #define DEFAULT_LASER_MODE 0 // false
  #define DEFAULT_HOMING_ENABLE 0  // false
  #define DEFAULT_HOMING_DIR_MASK 0 // move positive dir
  #define DEFAULT_HOMING_FEED_RATE 25.0 // mm/min
  #define DEFAULT_HOMING_SEEK_RATE 500.0 // mm/min
  #define DEFAULT_HOMING_DEBOUNCE_DELAY 250 // msec (0-65k)
  #define DEFAULT_HOMING_PULLOFF 1.0 // mm
#ifdef DEFAULTS_SHERLINE_5400
  #define MICROSTEPS 2
  #define STEPS_PER_REV 200.0
  #define MM_PER_REV (0.050*MM_PER_INCH) // 0.050 inch/rev leadscrew
  #define DEFAULT_X_STEPS_PER_MM (STEPS_PER_REV*MICROSTEPS/MM_PER_REV)
  #define DEFAULT_Y_STEPS_PER_MM (STEPS_PER_REV*MICROSTEPS/MM_PER_REV)
  #define DEFAULT_Z_STEPS_PER_MM (STEPS_PER_REV*MICROSTEPS/MM_PER_REV)
  #define DEFAULT_X_MAX_RATE 3000.0 // mm/min (25 ipm)
  #define DEFAULT_Y_MAX_RATE 3000.0 // mm/min
  #define DEFAULT_Z_MAX_RATE 3000.0 // mm/min
  #define DEFAULT_X_ACCELERATION (50.0*60*60) // 50*60*60 mm/min^2 = 50 mm/sec^2
  #define DEFAULT_Y_ACCELERATION (50.0*60*60) // 50*60*60 mm/min^2 = 50 mm/sec^2
  #define DEFAULT_Z_ACCELERATION (50.0*60*60) // 50*60*60 mm/min^2 = 50 mm/sec^2
  #define DEFAULT_X_MAX_TRAVEL 225.0 // mm NOTE: Must be a positive value.
  #define DEFAULT_Y_MAX_TRAVEL 125.0 // mm NOTE: Must be a positive value.
  #define DEFAULT_Z_MAX_TRAVEL 170.0 // mm NOTE: Must be a positive value.
  #define DEFAULT_SPINDLE_RPM_MAX 2800.0 // rpm
  #define DEFAULT_SPINDLE_RPM_MIN 0.0 // rpm
  #define DEFAULT_STEP_PULSE_MICROSECONDS 10
  #define DEFAULT_STEPPING_INVERT_MASK 0
  #define DEFAULT_DIRECTION_INVERT_MASK ((1<<Y_AXIS)|(1<<Z_AXIS))
  #define DEFAULT_STEPPER_IDLE_LOCK_TIME 25 // msec (0-254, 255 keeps steppers enabled)
  #define DEFAULT_STATUS_REPORT_MASK 1 // MPos enabled
  #define DEFAULT_JUNCTION_DEVIATION 0.01 // mm
  #define DEFAULT_ARC_TOLERANCE 0.002 // mm
  #define DEFAULT_REPORT_INCHES 0 // true
  #define DEFAULT_INVERT_ST_ENABLE 0 // false
  #define DEFAULT_INVERT_LIMIT_PINS 0 // false
  #define DEFAULT_SOFT_LIMIT_ENABLE 0 // false
  #define DEFAULT_HARD_LIMIT_ENABLE 0  // false
  #define DEFAULT_INVERT_PROBE_PIN 0 // false
  #define DEFAULT_LASER_MODE 0 // false
  #define DEFAULT_HOMING_ENABLE 0  // false
  #define DEFAULT_HOMING_DIR_MASK 0 // move positive dir
  #define DEFAULT_HOMING_FEED_RATE 50.0 // mm/min
  #define DEFAULT_HOMING_SEEK_RATE 635.0 // mm/min
  #define DEFAULT_HOMING_DEBOUNCE_DELAY 250 // msec (0-65k)
  #define DEFAULT_HOMING_PULLOFF 1.0 // mm
#endif
#ifdef DEFAULTS_POCKETNC_FR4
  #define DEFAULT_X_STEPS_PER_MM 800.0
  #define DEFAULT_Y_STEPS_PER_MM 800.0
  #define DEFAULT_Z_STEPS_PER_MM 800.0
  #define DEFAULT_X_MAX_RATE 300.0 // mm/min
  #define DEFAULT_Y_MAX_RATE 300.0 // mm/min
  #define DEFAULT_Z_MAX_RATE 300.0 // mm/min
  #define DEFAULT_X_ACCELERATION 500.0 // 15*60*60 mm/min^2 = 15 mm/sec^2
  #define DEFAULT_Y_ACCELERATION 500.0 // 15*60*60 mm/min^2 = 15 mm/sec^2
  #define DEFAULT_Z_ACCELERATION 200.0 // 15*60*60 mm/min^2 = 15 mm/sec^2
  #define DEFAULT_X_MAX_TRAVEL 200.0 // mm NOTE: Must be a positive value.
  #define DEFAULT_Y_MAX_TRAVEL 160.0 // mm NOTE: Must be a positive value.
  #define DEFAULT_Z_MAX_TRAVEL 50.0  // mm NOTE: Must be a positive value.
  #define DEFAULT_SPINDLE_RPM_MAX 7000.0 // rpm
  #define DEFAULT_SPINDLE_RPM_MIN 0.0 // rpm
  #define DEFAULT_STEP_PULSE_MICROSECONDS 10
  #define DEFAULT_STEPPING_INVERT_MASK 0
  #define DEFAULT_DIRECTION_INVERT_MASK ((1<<Y_AXIS)|(1<<Z_AXIS))
  #define DEFAULT_STEPPER_IDLE_LOCK_TIME 250 // msec (0-254, 255 keeps steppers enabled)
  #define DEFAULT_STATUS_REPORT_MASK 3 // WPos enabled
  #define DEFAULT_JUNCTION_DEVIATION 0.01 // mm
  #define DEFAULT_ARC_TOLERANCE 0.002 // mm
  #define DEFAULT_REPORT_INCHES 0 // false
  #define DEFAULT_INVERT_ST_ENABLE 1 // false
  #define DEFAULT_INVERT_LIMIT_PINS 0 // false
  #define DEFAULT_SOFT_LIMIT_ENABLE 0 // false
  #define DEFAULT_HARD_LIMIT_ENABLE 0  // false
  #define DEFAULT_INVERT_PROBE_PIN 0 // false
  #define DEFAULT_LASER_MODE 0 // false
  #define DEFAULT_HOMING_ENABLE 1  // false
  #define DEFAULT_HOMING_DIR_MASK 1 // move positive dir
  #define DEFAULT_HOMING_FEED_RATE 100.0 // mm/min
  #define DEFAULT_HOMING_SEEK_RATE 300.0 // mm/min
  #define DEFAULT_HOMING_DEBOUNCE_DELAY 250 // msec (0-65k)
  #define DEFAULT_HOMING_PULLOFF 3.0 // mm
#endif
#ifdef DEFAULTS_SHAPEOKO
  #define MICROSTEPS_XY 8
  #define STEP_REVS_XY 400
  #define MM_PER_REV_XY (0.08*18*MM_PER_INCH) // 0.08 in belt pitch, 18 pulley teeth
  #define MICROSTEPS_Z 2
  #define STEP_REVS_Z 400
  #define MM_PER_REV_Z 1.250 // 1.25 mm/rev leadscrew
  #define DEFAULT_X_STEPS_PER_MM (MICROSTEPS_XY*STEP_REVS_XY/MM_PER_REV_XY)
  #define DEFAULT_Y_STEPS_PER_MM (MICROSTEPS_XY*STEP_REVS_XY/MM_PER_REV_XY)
  #define DEFAULT_Z_STEPS_PER_MM (MICROSTEPS_Z*STEP_REVS_Z/MM_PER_REV_Z)
  #define DEFAULT_X_MAX_RATE 1000.0 // mm/min
  #define DEFAULT_Y_MAX_RATE 1000.0 // mm/min
  #define DEFAULT_Z_MAX_RATE 1000.0 // mm/min
  #define DEFAULT_X_ACCELERATION (15.0*60*60) // 15*60*60 mm/min^2 = 15 mm/sec^2
  #define DEFAULT_Y_ACCELERATION (15.0*60*60) // 15*60*60 mm/min^2 = 15 mm/sec^2
  #define DEFAULT_Z_ACCELERATION (15.0*60*60) // 15*60*60 mm/min^2 = 15 mm/sec^2
  #define DEFAULT_X_MAX_TRAVEL 200.0 // mm NOTE: Must be a positive value.
  #define DEFAULT_Y_MAX_TRAVEL 200.0 // mm NOTE: Must be a positive value.
  #define DEFAULT_Z_MAX_TRAVEL 200.0 // mm NOTE: Must be a positive value.
  #define DEFAULT_SPINDLE_RPM_MAX 10000.0 // rpm
  #define DEFAULT_SPINDLE_RPM_MIN 0.0 // rpm
  #define DEFAULT_STEP_PULSE_MICROSECONDS 10
  #define DEFAULT_STEPPING_INVERT_MASK 0
  #define DEFAULT_DIRECTION_INVERT_MASK ((1<<Y_AXIS)|(1<<Z_AXIS))
  #define DEFAULT_STEPPER_IDLE_LOCK_TIME 255 // msec (0-254, 255 keeps steppers enabled)
  #define DEFAULT_STATUS_REPORT_MASK 1 // MPos enabled
  #define DEFAULT_JUNCTION_DEVIATION 0.01 // mm
  #define DEFAULT_ARC_TOLERANCE 0.002 // mm
  #define DEFAULT_REPORT_INCHES 0 // false
  #define DEFAULT_INVERT_ST_ENABLE 0 // false
  #define DEFAULT_INVERT_LIMIT_PINS 0 // false
  #define DEFAULT_SOFT_LIMIT_ENABLE 0 // false
  #define DEFAULT_HARD_LIMIT_ENABLE 0  // false
  #define DEFAULT_INVERT_PROBE_PIN 0 // false
  #define DEFAULT_LASER_MODE 0 // false
  #define DEFAULT_HOMING_ENABLE 0  // false
  #define DEFAULT_HOMING_DIR_MASK 0 // move positive dir
  #define DEFAULT_HOMING_FEED_RATE 25.0 // mm/min
  #define DEFAULT_HOMING_SEEK_RATE 250.0 // mm/min
  #define DEFAULT_HOMING_DEBOUNCE_DELAY 250 // msec (0-65k)
  #define DEFAULT_HOMING_PULLOFF 1.0 // mm
#endif
#ifdef DEFAULTS_SHAPEOKO_2
  #define MICROSTEPS_XY 8
  #define STEP_REVS_XY 200
  #define MM_PER_REV_XY (2.0*20) // 2mm belt pitch, 20 pulley teeth
  #define MICROSTEPS_Z 2
  #define STEP_REVS_Z 200
  #define MM_PER_REV_Z 1.250 // 1.25 mm/rev leadscrew
  #define DEFAULT_X_STEPS_PER_MM (MICROSTEPS_XY*STEP_REVS_XY/MM_PER_REV_XY)
  #define DEFAULT_Y_STEPS_PER_MM (MICROSTEPS_XY*STEP_REVS_XY/MM_PER_REV_XY)
  #define DEFAULT_Z_STEPS_PER_MM (MICROSTEPS_Z*STEP_REVS_Z/MM_PER_REV_Z)
  #define DEFAULT_X_MAX_RATE 5000.0 // mm/min
  #define DEFAULT_Y_MAX_RATE 5000.0 // mm/min
  #define DEFAULT_Z_MAX_RATE 500.0 // mm/min
  #define DEFAULT_X_ACCELERATION (250.0*60*60) // 25*60*60 mm/min^2 = 25 mm/sec^2
  #define DEFAULT_Y_ACCELERATION (250.0*60*60) // 25*60*60 mm/min^2 = 25 mm/sec^2
  #define DEFAULT_Z_ACCELERATION (50.0*60*60) // 25*60*60 mm/min^2 = 25 mm/sec^2
  #define DEFAULT_X_MAX_TRAVEL 290.0 // mm NOTE: Must be a positive value.
  #define DEFAULT_Y_MAX_TRAVEL 290.0 // mm NOTE: Must be a positive value.
  #define DEFAULT_Z_MAX_TRAVEL 100.0 // mm NOTE: Must be a positive value.
  #define DEFAULT_SPINDLE_RPM_MAX 10000.0 // rpm
  #define DEFAULT_SPINDLE_RPM_MIN 0.0 // rpm
  #define DEFAULT_STEP_PULSE_MICROSECONDS 10
  #define DEFAULT_STEPPING_INVERT_MASK 0
  #define DEFAULT_DIRECTION_INVERT_MASK ((1<<X_AXIS)|(1<<Z_AXIS))
  #define DEFAULT_STEPPER_IDLE_LOCK_TIME 255 // msec (0-254, 255 keeps steppers enabled)
  #define DEFAULT_STATUS_REPORT_MASK 1 // MPos enabled
  #define DEFAULT_JUNCTION_DEVIATION 0.02 // mm
  #define DEFAULT_ARC_TOLERANCE 0.002 // mm
  #define DEFAULT_REPORT_INCHES 0 // false
  #define DEFAULT_INVERT_ST_ENABLE 1 // false
  #define DEFAULT_INVERT_LIMIT_PINS 0 // false
  #define DEFAULT_SOFT_LIMIT_ENABLE 0 // false
  #define DEFAULT_HARD_LIMIT_ENABLE 0  // false
  #define DEFAULT_INVERT_PROBE_PIN 0 // false
  #define DEFAULT_LASER_MODE 0 // false
  #define DEFAULT_HOMING_ENABLE 0  // false
  #define DEFAULT_HOMING_DIR_MASK 0 // move positive dir
  #define DEFAULT_HOMING_FEED_RATE 25.0 // mm/min
  #define DEFAULT_HOMING_SEEK_RATE 250.0 // mm/min
  #define DEFAULT_HOMING_DEBOUNCE_DELAY 250 // msec (0-65k)
  #define DEFAULT_HOMING_PULLOFF 1.0 // mm
#endif
#ifdef DEFAULTS_SHAPEOKO_3
  #define MICROSTEPS_XY 8
  #define STEP_REVS_XY 200
  #define MM_PER_REV_XY (2.0*20) // 2mm belt pitch, 20 pulley teeth
  #define MICROSTEPS_Z 8
  #define STEP_REVS_Z 200
  #define MM_PER_REV_Z (2.0*20) // 2mm belt pitch, 20 pulley teeth
  #define DEFAULT_X_STEPS_PER_MM (MICROSTEPS_XY*STEP_REVS_XY/MM_PER_REV_XY)
  #define DEFAULT_Y_STEPS_PER_MM (MICROSTEPS_XY*STEP_REVS_XY/MM_PER_REV_XY)
  #define DEFAULT_Z_STEPS_PER_MM (MICROSTEPS_Z*STEP_REVS_Z/MM_PER_REV_Z)
  #define DEFAULT_X_MAX_RATE 5000.0 // mm/min
  #define DEFAULT_Y_MAX_RATE 5000.0 // mm/min
  #define DEFAULT_Z_MAX_RATE 5000.0 // mm/min
  #define DEFAULT_X_ACCELERATION (400.0*60*60) // 400*60*60 mm/min^2 = 400 mm/sec^2
  #define DEFAULT_Y_ACCELERATION (400.0*60*60) // 400*60*60 mm/min^2 = 400 mm/sec^2
  #define DEFAULT_Z_ACCELERATION (400.0*60*60) // 400*60*60 mm/min^2 = 400 mm/sec^2
  #define DEFAULT_X_MAX_TRAVEL 425.0 // mm NOTE: Must be a positive value.
  #define DEFAULT_Y_MAX_TRAVEL 465.0 // mm NOTE: Must be a positive value.
  #define DEFAULT_Z_MAX_TRAVEL 80.0 // mm NOTE: Must be a positive value.
  #define DEFAULT_SPINDLE_RPM_MAX 10000.0 // rpm
  #define DEFAULT_SPINDLE_RPM_MIN 0.0 // rpm
  #define DEFAULT_STEP_PULSE_MICROSECONDS 10
  #define DEFAULT_STEPPING_INVERT_MASK 0
  #define DEFAULT_DIRECTION_INVERT_MASK ((1<<X_AXIS)|(1<<Z_AXIS))
  #define DEFAULT_STEPPER_IDLE_LOCK_TIME 255 // msec (0-254, 255 keeps steppers enabled)
  #define DEFAULT_STATUS_REPORT_MASK 1 // MPos enabled
  #define DEFAULT_JUNCTION_DEVIATION 0.02 // mm
  #define DEFAULT_ARC_TOLERANCE 0.01 // mm
  #define DEFAULT_REPORT_INCHES 0 // false
  #define DEFAULT_INVERT_ST_ENABLE 0 // false
  #define DEFAULT_INVERT_LIMIT_PINS 0 // false
  #define DEFAULT_SOFT_LIMIT_ENABLE 0 // false
  #define DEFAULT_HARD_LIMIT_ENABLE 0  // false
  #define DEFAULT_INVERT_PROBE_PIN 0 // false
  #define DEFAULT_LASER_MODE 0 // false
  #define DEFAULT_HOMING_ENABLE 0  // false
  #define DEFAULT_HOMING_DIR_MASK 0 // move positive dir
  #define DEFAULT_HOMING_FEED_RATE 100.0 // mm/min
  #define DEFAULT_HOMING_SEEK_RATE 1000.0 // mm/min
  #define DEFAULT_HOMING_DEBOUNCE_DELAY 25 // msec (0-65k)
  #define DEFAULT_HOMING_PULLOFF 5.0 // mm
#endif
#ifdef DEFAULTS_X_CARVE_500MM
  #define MICROSTEPS_XY 8
  #define STEP_REVS_XY 200
  #define MM_PER_REV_XY (2.0*20) // 2mm belt pitch, 20 pulley teeth
  #define MICROSTEPS_Z 2
  #define STEP_REVS_Z 200
  #define MM_PER_REV_Z 2.117 // ACME 3/8-12 Leadscrew
  #define DEFAULT_X_STEPS_PER_MM (MICROSTEPS_XY*STEP_REVS_XY/MM_PER_REV_XY)
  #define DEFAULT_Y_STEPS_PER_MM (MICROSTEPS_XY*STEP_REVS_XY/MM_PER_REV_XY)
  #define DEFAULT_Z_STEPS_PER_MM (MICROSTEPS_Z*STEP_REVS_Z/MM_PER_REV_Z)
  #define DEFAULT_X_MAX_RATE 8000.0 // mm/min
  #define DEFAULT_Y_MAX_RATE 8000.0 // mm/min
  #define DEFAULT_Z_MAX_RATE 500.0 // mm/min
  #define DEFAULT_X_ACCELERATION (500.0*60*60) // 25*60*60 mm/min^2 = 25 mm/sec^2
  #define DEFAULT_Y_ACCELERATION (500.0*60*60) // 25*60*60 mm/min^2 = 25 mm/sec^2
  #define DEFAULT_Z_ACCELERATION (50.0*60*60) // 25*60*60 mm/min^2 = 25 mm/sec^2
  #define DEFAULT_X_MAX_TRAVEL 290.0 // mm NOTE: Must be a positive value.
  #define DEFAULT_Y_MAX_TRAVEL 290.0 // mm NOTE: Must be a positive value.
  #define DEFAULT_Z_MAX_TRAVEL 100.0 // mm NOTE: Must be a positive value.
  #define DEFAULT_SPINDLE_RPM_MAX 10000.0 // rpm
  #define DEFAULT_SPINDLE_RPM_MIN 0.0 // rpm
  #define DEFAULT_STEP_PULSE_MICROSECONDS 10
  #define DEFAULT_STEPPING_INVERT_MASK 0
  #define DEFAULT_DIRECTION_INVERT_MASK ((1<<X_AXIS)|(1<<Y_AXIS))
  #define DEFAULT_STEPPER_IDLE_LOCK_TIME 255 // msec (0-254, 255 keeps steppers enabled)
  #define DEFAULT_STATUS_REPORT_MASK 1 // MPos enabled
  #define DEFAULT_JUNCTION_DEVIATION 0.02 // mm
  #define DEFAULT_ARC_TOLERANCE 0.002 // mm
  #define DEFAULT_REPORT_INCHES 0 // false
  #define DEFAULT_INVERT_ST_ENABLE 0 // false
  #define DEFAULT_INVERT_LIMIT_PINS 0 // false
  #define DEFAULT_SOFT_LIMIT_ENABLE 0 // false
  #define DEFAULT_HARD_LIMIT_ENABLE 0  // false
  #define DEFAULT_INVERT_PROBE_PIN 0 // false
  #define DEFAULT_LASER_MODE 0 // false
  #define DEFAULT_HOMING_ENABLE 0  // false
  #define DEFAULT_HOMING_DIR_MASK 3 // move positive dir
  #define DEFAULT_HOMING_FEED_RATE 25.0 // mm/min
  #define DEFAULT_HOMING_SEEK_RATE 750.0 // mm/min
  #define DEFAULT_HOMING_DEBOUNCE_DELAY 250 // msec (0-65k)
  #define DEFAULT_HOMING_PULLOFF 1.0 // mm
#endif
#ifdef DEFAULTS_X_CARVE_1000MM
  #define MICROSTEPS_XY 8
  #define STEP_REVS_XY 200
  #define MM_PER_REV_XY (2.0*20) // 2mm belt pitch, 20 pulley teeth
  #define MICROSTEPS_Z 2
  #define STEP_REVS_Z 200
  #define MM_PER_REV_Z 2.117 // ACME 3/8-12 Leadscrew
  #define DEFAULT_X_STEPS_PER_MM (MICROSTEPS_XY*STEP_REVS_XY/MM_PER_REV_XY)
  #define DEFAULT_Y_STEPS_PER_MM (MICROSTEPS_XY*STEP_REVS_XY/MM_PER_REV_XY)
  #define DEFAULT_Z_STEPS_PER_MM (MICROSTEPS_Z*STEP_REVS_Z/MM_PER_REV_Z)
  #define DEFAULT_X_MAX_RATE 8000.0 // mm/min
  #define DEFAULT_Y_MAX_RATE 8000.0 // mm/min
  #define DEFAULT_Z_MAX_RATE 500.0 // mm/min
  #define DEFAULT_X_ACCELERATION (500.0*60*60) // 25*60*60 mm/min^2 = 25 mm/sec^2
  #define DEFAULT_Y_ACCELERATION (500.0*60*60) // 25*60*60 mm/min^2 = 25 mm/sec^2
  #define DEFAULT_Z_ACCELERATION (50.0*60*60) // 25*60*60 mm/min^2 = 25 mm/sec^2
  #define DEFAULT_X_MAX_TRAVEL 740.0 // mm NOTE: Must be a positive value.
  #define DEFAULT_Y_MAX_TRAVEL 790.0 // mm NOTE: Must be a positive value.
  #define DEFAULT_Z_MAX_TRAVEL 100.0 // mm NOTE: Must be a positive value.
  #define DEFAULT_SPINDLE_RPM_MAX 10000.0 // rpm
  #define DEFAULT_SPINDLE_RPM_MIN 0.0 // rpm
  #define DEFAULT_STEP_PULSE_MICROSECONDS 10
  #define DEFAULT_STEPPING_INVERT_MASK 0
  #define DEFAULT_DIRECTION_INVERT_MASK ((1<<X_AXIS)|(1<<Y_AXIS))
  #define DEFAULT_STEPPER_IDLE_LOCK_TIME 255 // msec (0-254, 255 keeps steppers enabled)
  #define DEFAULT_STATUS_REPORT_MASK 1 // MPos enabled
  #define DEFAULT_JUNCTION_DEVIATION 0.02 // mm
  #define DEFAULT_ARC_TOLERANCE 0.002 // mm
  #define DEFAULT_REPORT_INCHES 0 // false
  #define DEFAULT_INVERT_ST_ENABLE 0 // false
  #define DEFAULT_INVERT_LIMIT_PINS 0 // false
  #define DEFAULT_SOFT_LIMIT_ENABLE 0 // false
  #define DEFAULT_HARD_LIMIT_ENABLE 0  // false
  #define DEFAULT_INVERT_PROBE_PIN 0 // false
  #define DEFAULT_LASER_MODE 0 // false
  #define DEFAULT_HOMING_ENABLE 0  // false
  #define DEFAULT_HOMING_DIR_MASK 3 // move positive dir
  #define DEFAULT_HOMING_FEED_RATE 25.0 // mm/min
  #define DEFAULT_HOMING_SEEK_RATE 750.0 // mm/min
  #define DEFAULT_HOMING_DEBOUNCE_DELAY 250 // msec (0-65k)
  #define DEFAULT_HOMING_PULLOFF 1.0 // mm
#endif
#ifdef DEFAULTS_BOBSCNC_E3
  #define DEFAULT_X_STEPS_PER_MM 80.0
  #define DEFAULT_Y_STEPS_PER_MM 80.0
  #define DEFAULT_Z_STEPS_PER_MM 2267.717
  #define DEFAULT_X_MAX_RATE 10000.0 // mm/min
  #define DEFAULT_Y_MAX_RATE 10000.0 // mm/min
  #define DEFAULT_Z_MAX_RATE 500.0 // mm/min
  #define DEFAULT_X_ACCELERATION (500.0*60*60) // 10*60*60 mm/min^2 = 10 mm/sec^2
  #define DEFAULT_Y_ACCELERATION (500.0*60*60) // 10*60*60 mm/min^2 = 10 mm/sec^2
  #define DEFAULT_Z_ACCELERATION (300.0*60*60) // 10*60*60 mm/min^2 = 10 mm/sec^2
  #define DEFAULT_X_MAX_TRAVEL 450.0 // mm NOTE: Must be a positive value.
  #define DEFAULT_Y_MAX_TRAVEL 390.0 // mm NOTE: Must be a positive value.
  #define DEFAULT_Z_MAX_TRAVEL 85.0 // mm NOTE: Must be a positive value.
  #define DEFAULT_SPINDLE_RPM_MAX 1000.0 // rpm
  #define DEFAULT_SPINDLE_RPM_MIN 0.0 // rpm
  #define DEFAULT_STEP_PULSE_MICROSECONDS 5
  #define DEFAULT_STEPPING_INVERT_MASK 0
  #define DEFAULT_DIRECTION_INVERT_MASK 0
  #define DEFAULT_STEPPER_IDLE_LOCK_TIME 25 // msec (0-254, 255 keeps steppers enabled)
  #define DEFAULT_STATUS_REPORT_MASK 1 // MPos enabled
  #define DEFAULT_JUNCTION_DEVIATION 0.01 // mm
  #define DEFAULT_ARC_TOLERANCE 0.002 // mm
  #define DEFAULT_REPORT_INCHES 1 // true
  #define DEFAULT_INVERT_ST_ENABLE 0 // false
  #define DEFAULT_INVERT_LIMIT_PINS 1 // true
  #define DEFAULT_SOFT_LIMIT_ENABLE 1 // true
  #define DEFAULT_HARD_LIMIT_ENABLE 0  // false
  #define DEFAULT_INVERT_PROBE_PIN 0 // false
  #define DEFAULT_LASER_MODE 0 // false
  #define DEFAULT_HOMING_ENABLE 1  // true
  #define DEFAULT_HOMING_DIR_MASK 3 // move xy -dir, z dir
  #define DEFAULT_HOMING_FEED_RATE 500.0 // mm/min
  #define DEFAULT_HOMING_SEEK_RATE 4000.0 // mm/min
  #define DEFAULT_HOMING_DEBOUNCE_DELAY 250 // msec (0-65k)
  #define DEFAULT_HOMING_PULLOFF 5.0 // mm
#endif
#ifdef DEFAULTS_BOBSCNC_E4
  #define DEFAULT_X_STEPS_PER_MM 80.0
  #define DEFAULT_Y_STEPS_PER_MM 80.0
  #define DEFAULT_Z_STEPS_PER_MM 2267.717
  #define DEFAULT_X_MAX_RATE 10000.0 // mm/min
  #define DEFAULT_Y_MAX_RATE 10000.0 // mm/min
  #define DEFAULT_Z_MAX_RATE 500.0 // mm/min
  #define DEFAULT_X_ACCELERATION (500.0*60*60) // 10*60*60 mm/min^2 = 10 mm/sec^2
  #define DEFAULT_Y_ACCELERATION (500.0*60*60) // 10*60*60 mm/min^2 = 10 mm/sec^2
  #define DEFAULT_Z_ACCELERATION (300.0*60*60) // 10*60*60 mm/min^2 = 10 mm/sec^2
  #define DEFAULT_X_MAX_TRAVEL 610.0 // mm NOTE: Must be a positive value.
  #define DEFAULT_Y_MAX_TRAVEL 610.0 // mm NOTE: Must be a positive value.
  #define DEFAULT_Z_MAX_TRAVEL 85.0 // mm NOTE: Must be a positive value.
  #define DEFAULT_SPINDLE_RPM_MAX 1000.0 // rpm
  #define DEFAULT_SPINDLE_RPM_MIN 0.0 // rpm
  #define DEFAULT_STEP_PULSE_MICROSECONDS 5
  #define DEFAULT_STEPPING_INVERT_MASK 0
  #define DEFAULT_DIRECTION_INVERT_MASK 0
  #define DEFAULT_STEPPER_IDLE_LOCK_TIME 25 // msec (0-254, 255 keeps steppers enabled)
  #define DEFAULT_STATUS_REPORT_MASK 1 // MPos enabled
  #define DEFAULT_JUNCTION_DEVIATION 0.01 // mm
  #define DEFAULT_ARC_TOLERANCE 0.002 // mm
  #define DEFAULT_REPORT_INCHES 1 // true
  #define DEFAULT_INVERT_ST_ENABLE 0 // false
  #define DEFAULT_INVERT_LIMIT_PINS 1 // true
  #define DEFAULT_SOFT_LIMIT_ENABLE 1 // true
  #define DEFAULT_HARD_LIMIT_ENABLE 0  // false
  #define DEFAULT_INVERT_PROBE_PIN 0 // false
  #define DEFAULT_LASER_MODE 0 // false
  #define DEFAULT_HOMING_ENABLE 1  // true
  #define DEFAULT_HOMING_DIR_MASK 3 // move xy -dir, z dir
  #define DEFAULT_HOMING_FEED_RATE 500.0 // mm/min
  #define DEFAULT_HOMING_SEEK_RATE 4000.0 // mm/min
  #define DEFAULT_HOMING_DEBOUNCE_DELAY 250 // msec (0-65k)
  #define DEFAULT_HOMING_PULLOFF 5.0 // mm
#endif
#ifdef DEFAULTS_ZEN_TOOLWORKS_7x7
  #define MICROSTEPS 8
  #define STEPS_PER_REV 200.0
  #define MM_PER_REV 8.0 // 8 mm/rev leadscrew
  #define DEFAULT_X_STEPS_PER_MM (STEPS_PER_REV*MICROSTEPS/MM_PER_REV)
  #define DEFAULT_Y_STEPS_PER_MM (STEPS_PER_REV*MICROSTEPS/MM_PER_REV)
  #define DEFAULT_Z_STEPS_PER_MM (STEPS_PER_REV*MICROSTEPS/MM_PER_REV)
  #define DEFAULT_X_MAX_RATE 6000.0 // mm/min
  #define DEFAULT_Y_MAX_RATE 6000.0 // mm/min
  #define DEFAULT_Z_MAX_RATE 6000.0 // mm/min
  #define DEFAULT_X_ACCELERATION (600.0*60*60) // 600*60*60 mm/min^2 = 600 mm/sec^2
  #define DEFAULT_Y_ACCELERATION (600.0*60*60) // 600*60*60 mm/min^2 = 600 mm/sec^2
  #define DEFAULT_Z_ACCELERATION (600.0*60*60) // 600*60*60 mm/min^2 = 600 mm/sec^2
  #define DEFAULT_X_MAX_TRAVEL 190.0 // mm NOTE: Must be a positive value.
  #define DEFAULT_Y_MAX_TRAVEL 180.0 // mm NOTE: Must be a positive value.
  #define DEFAULT_Z_MAX_TRAVEL 150.0 // mm NOTE: Must be a positive value.
  #define DEFAULT_SPINDLE_RPM_MAX 10000.0 // rpm
  #define DEFAULT_SPINDLE_RPM_MIN 0.0 // rpm
  #define DEFAULT_STEP_PULSE_MICROSECONDS 10
  #define DEFAULT_STEPPING_INVERT_MASK 0
  #define DEFAULT_DIRECTION_INVERT_MASK ((1<<Y_AXIS))
  #define DEFAULT_STEPPER_IDLE_LOCK_TIME 25 // msec (0-254, 255 keeps steppers enabled)
  #define DEFAULT_STATUS_REPORT_MASK 1 // MPos enabled
  #define DEFAULT_JUNCTION_DEVIATION 0.02 // mm
  #define DEFAULT_ARC_TOLERANCE 0.002 // mm
  #define DEFAULT_REPORT_INCHES 0 // false
  #define DEFAULT_INVERT_ST_ENABLE 0 // false
  #define DEFAULT_INVERT_LIMIT_PINS 0 // false
  #define DEFAULT_SOFT_LIMIT_ENABLE 0 // false
  #define DEFAULT_HARD_LIMIT_ENABLE 0  // false
  #define DEFAULT_INVERT_PROBE_PIN 0 // false
  #define DEFAULT_LASER_MODE 0 // false
  #define DEFAULT_HOMING_ENABLE 0  // false
  #define DEFAULT_HOMING_DIR_MASK 0 // move positive dir
  #define DEFAULT_HOMING_FEED_RATE 25.0 // mm/min
  #define DEFAULT_HOMING_SEEK_RATE 250.0 // mm/min
  #define DEFAULT_HOMING_DEBOUNCE_DELAY 250 // msec (0-65k)
  #define DEFAULT_HOMING_PULLOFF 1.0 // mm
#endif
#ifdef DEFAULTS_OXCNC
  #define DEFAULT_X_STEPS_PER_MM 26.670
  #define DEFAULT_Y_STEPS_PER_MM 26.670
  #define DEFAULT_Z_STEPS_PER_MM 50
  #define DEFAULT_X_MAX_RATE 500.0 // mm/min
  #define DEFAULT_Y_MAX_RATE 500.0 // mm/min
  #define DEFAULT_Z_MAX_RATE 500.0 // mm/min
  #define DEFAULT_X_ACCELERATION (10.0*60*60) // 10*60*60 mm/min^2 = 10 mm/sec^2
  #define DEFAULT_Y_ACCELERATION (10.0*60*60) // 10*60*60 mm/min^2 = 10 mm/sec^2
  #define DEFAULT_Z_ACCELERATION (10.0*60*60) // 10*60*60 mm/min^2 = 10 mm/sec^2
  #define DEFAULT_X_MAX_TRAVEL 500.0 // mm NOTE: Must be a positive value.
  #define DEFAULT_Y_MAX_TRAVEL 750.0 // mm NOTE: Must be a positive value.
  #define DEFAULT_Z_MAX_TRAVEL 80.0 // mm NOTE: Must be a positive value.
  #define DEFAULT_SPINDLE_RPM_MAX 1000.0 // rpm
  #define DEFAULT_SPINDLE_RPM_MIN 0.0 // rpm
  #define DEFAULT_STEP_PULSE_MICROSECONDS 10
  #define DEFAULT_STEPPING_INVERT_MASK 0
  #define DEFAULT_DIRECTION_INVERT_MASK 0
  #define DEFAULT_STEPPER_IDLE_LOCK_TIME 25 // msec (0-254, 255 keeps steppers enabled)
  #define DEFAULT_STATUS_REPORT_MASK 1 // MPos enabled
  #define DEFAULT_JUNCTION_DEVIATION 0.02 // mm
  #define DEFAULT_ARC_TOLERANCE 0.002 // mm
  #define DEFAULT_REPORT_INCHES 0 // false
  #define DEFAULT_INVERT_ST_ENABLE 0 // false
  #define DEFAULT_INVERT_LIMIT_PINS 0 // false
  #define DEFAULT_SOFT_LIMIT_ENABLE 0 // false
  #define DEFAULT_HARD_LIMIT_ENABLE 0  // false
  #define DEFAULT_INVERT_PROBE_PIN 0 // false
  #define DEFAULT_LASER_MODE 0 // false
  #define DEFAULT_HOMING_ENABLE 0  // false
  #define DEFAULT_HOMING_DIR_MASK 0 // move positive dir
  #define DEFAULT_HOMING_FEED_RATE 25.0 // mm/min
  #define DEFAULT_HOMING_SEEK_RATE 500.0 // mm/min
  #define DEFAULT_HOMING_DEBOUNCE_DELAY 250 // msec (0-65k)
  #define DEFAULT_HOMING_PULLOFF 1.0 // mm
#endif
#ifdef DEFAULTS_SIMULATOR
  #define DEFAULT_X_STEPS_PER_MM 1000.0
  #define DEFAULT_Y_STEPS_PER_MM 1000.0
  #define DEFAULT_Z_STEPS_PER_MM 1000.0
  #define DEFAULT_X_MAX_RATE 1000.0 // mm/min
  #define DEFAULT_Y_MAX_RATE 1000.0 // mm/min
  #define DEFAULT_Z_MAX_RATE 1000.0 // mm/min
  #define DEFAULT_X_ACCELERATION (100.0*60*60) // 10*60*60 mm/min^2 = 10 mm/sec^2
  #define DEFAULT_Y_ACCELERATION (100.0*60*60) // 10*60*60 mm/min^2 = 10 mm/sec^2
  #define DEFAULT_Z_ACCELERATION (100.0*60*60) // 10*60*60 mm/min^2 = 10 mm/sec^2
  #define DEFAULT_X_MAX_TRAVEL 1000.0 // mm NOTE: Must be a positive value.
  #define DEFAULT_Y_MAX_TRAVEL 1000.0 // mm NOTE: Must be a positive value.
  #define DEFAULT_Z_MAX_TRAVEL 1000.0 // mm NOTE: Must be a positive value.
  #define DEFAULT_SPINDLE_RPM_MAX 1000.0 // rpm
  #define DEFAULT_SPINDLE_RPM_MIN 0.0 // rpm
  #define DEFAULT_STEP_PULSE_MICROSECONDS 10
  #define DEFAULT_STEPPING_INVERT_MASK 0
  #define DEFAULT_DIRECTION_INVERT_MASK 0
  #define DEFAULT_STEPPER_IDLE_LOCK_TIME 25 // msec (0-254, 255 keeps steppers enabled)
  #define DEFAULT_STATUS_REPORT_MASK 1 // MPos enabled
  #define DEFAULT_JUNCTION_DEVIATION 0.01 // mm
  #define DEFAULT_ARC_TOLERANCE 0.002 // mm
  #define DEFAULT_REPORT_INCHES 0 // false
  #define DEFAULT_INVERT_ST_ENABLE 0 // false
  #define DEFAULT_INVERT_LIMIT_PINS 0 // false
  #define DEFAULT_SOFT_LIMIT_ENABLE 0 // false
  #define DEFAULT_HARD_LIMIT_ENABLE 0  // false
  #define DEFAULT_INVERT_PROBE_PIN 0 // false
  #define DEFAULT_LASER_MODE 0 // false
  #define DEFAULT_HOMING_ENABLE 0  // false
  #define DEFAULT_HOMING_DIR_MASK 0 // move positive dir
  #define DEFAULT_HOMING_FEED_RATE 25.0 // mm/min
  #define DEFAULT_HOMING_SEEK_RATE 500.0 // mm/min
  #define DEFAULT_HOMING_DEBOUNCE_DELAY 250 // msec (0-65k)
  #define DEFAULT_HOMING_PULLOFF 1.0 // mm
#endif
