Hui404/CoreScribe/(commit log)

2026-03-18 README 修改
2026-03-18 README修改
2026-03-18 README修改、增加3D文件
    [MGN9C滑块.SLDPRT, MGN9H滑块.SLDPRT, SG90.SLDPRT, 一字连接片2020型2孔.SLDPRT, 内六角台阶螺钉5xM4x10.SLDPRT, 内六角台阶螺钉5xM4x20.SLDPRT, 内六角平圆头螺钉M3x8.SLDPRT, 内六角平圆头螺钉M5x20.SLDPRT]
2026-03-18 添加3D打印文件
    [固定连接.STL, 定柱_前.STL, 定柱_后.STL, 控制器外壳1.STL, 控制器外壳2.STL, 显示器支架1.STL, 显示器支架2.STL, 电机增高柱.STL]
2026-03-19 REAMDE修改
2026-04-16 增加上位机软件
2026-04-21 添加触摸校准功能
2026-04-25 README添加视频展示地址
2026-04-27 修复EEPROM无法保存grbl配置
