Hui404/CoreScribe/(notices)

Notices in the files:
sys/sys.h:
@license Copyright (c) 2020-2032, ¹ãÖÝÊÐÐÇÒíµç×Ó¿Æ¼¼ÓÐÏÞ¹«Ë¾
Core/Src/main.c:
Copyright (c) 2026 STMicroelectronics.
All rights reserved.
This software is licensed under terms that can be found in the LICENSE file
grbl/cpu_map.h:
Grbl is free software: you can redistribute it and/or modify
it under the terms of the GNU General Public License as published by
the Free Software Foundation, either version 3 of the License, or
(at your option) any later version.
grbl/config.h:
Copyright (c) 2009-2011 Simen Svale Skogsrud
README.md:
License: Multi-License
